LouisYOSHINAGA/rtsynth/kicad/pihat/rtsynth_pihat.kicad_sch

## KiCad design kicad/pihat/rtsynth_pihat.kicad_sch (2026-11-04)

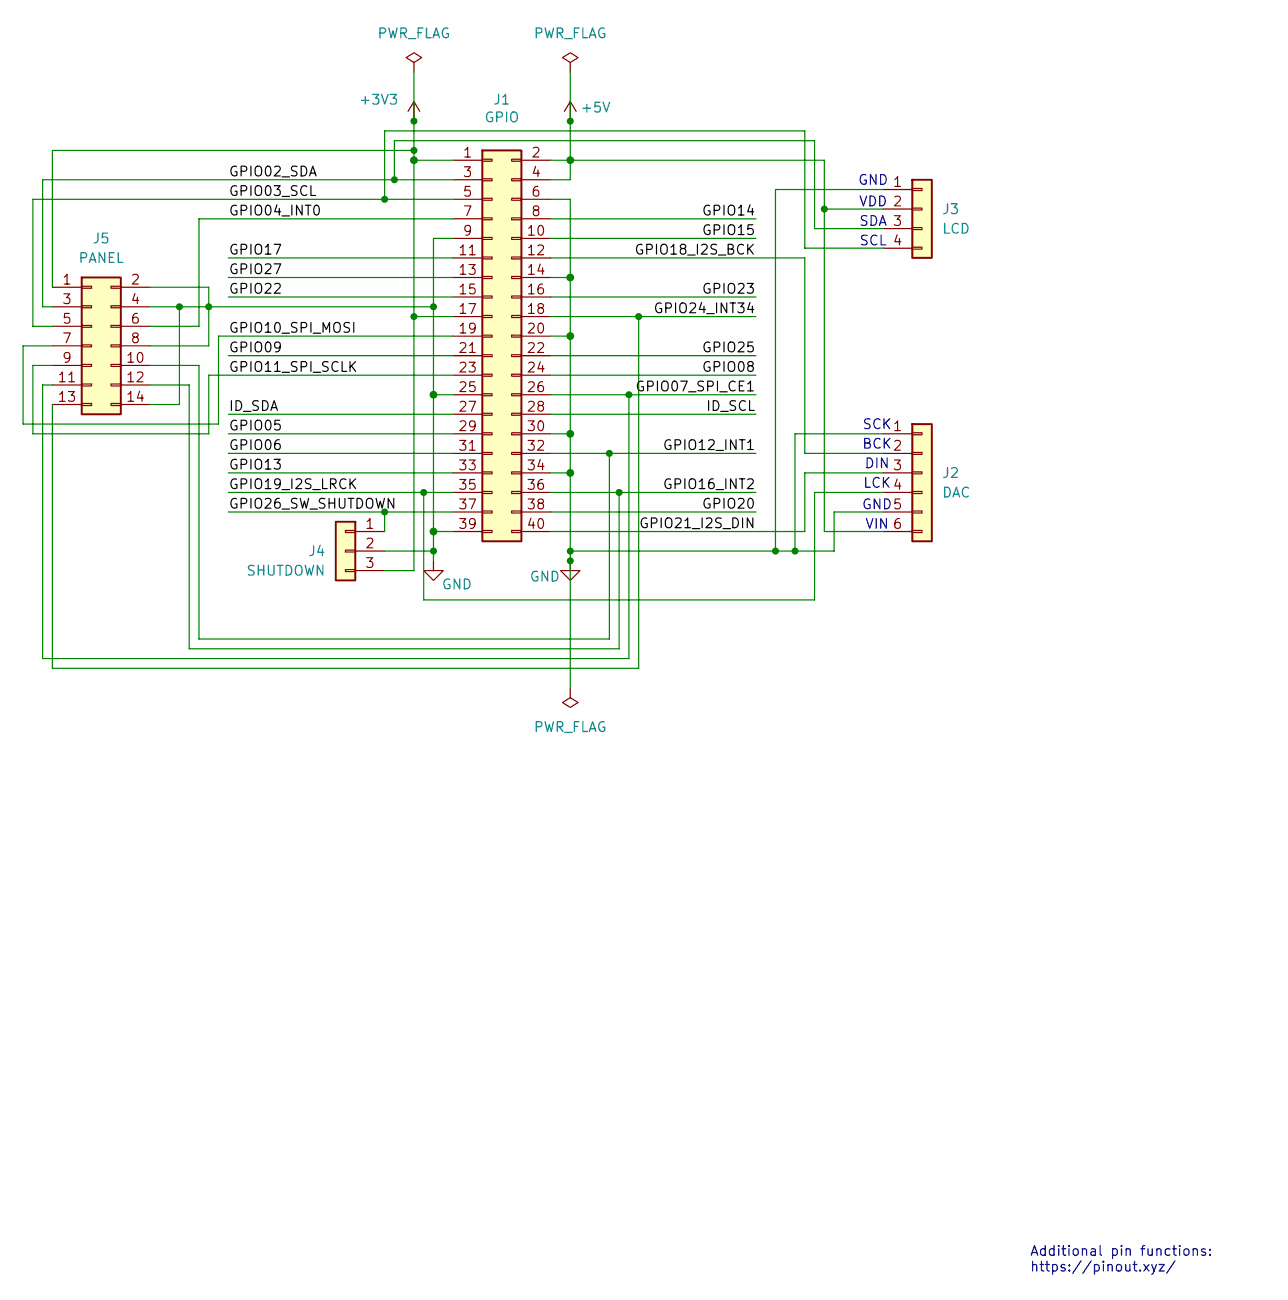
[picture p1: schematic rtsynth_pihat.kicad_sch]

Parts:
J1: GPIO; PinSocket_2x20_P2.54mm_Vertical
J2: DAC
J3: LCD
J4: SHUTDOWN
J5: PANEL

Connections:
+3V3: J1.1, J1.17, J4.3, J5.1
+5V: J1.2, J1.4, J2.6, J3.2
GND: J1.6, J1.9, J1.14, J1.20, J1.25, J1.30, J1.34, J1.39, J2.1, J2.5, J3.1, J4.2, J5.2, J5.4, J5.8, J5.14
GPIO02_SDA: J1.3, J3.3, J5.3
GPIO03_SCL: J1.5, J3.4, J5.5
GPIO04_INT0: J1.7, J5.6
GPIO05: J1.29
GPIO06: J1.31
GPIO07_SPI_CE1: J1.26, J5.11
GPIO08: J1.24
GPIO09: J1.21
GPIO10_SPI_MOSI: J1.19, J5.7
GPIO11_SPI_SCLK: J1.23, J5.9
GPIO12_INT1: J1.32, J5.10
GPIO13: J1.33
GPIO14: J1.8
GPIO15: J1.10
GPIO16_INT2: J1.36, J5.12
GPIO17: J1.11
GPIO18_I2S_BCK: J1.12, J2.2
GPIO19_I2S_LRCK: J1.35, J2.4
GPIO20: J1.38
GPIO21_I2S_DIN: J1.40, J2.3
GPIO22: J1.15
GPIO23: J1.16
GPIO24_INT34: J1.18, J5.13
GPIO25: J1.22
GPIO26_SW_SHUTDOWN: J1.37, J4.1
GPIO27: J1.13
ID_SCL: J1.28
ID_SDA: J1.27

Notes on the sheet:
SCL
VDD
VIN
GND
SDA
LCK
Additional pin functions: https://pinout.xyz/
BCK
DIN
SCK
