LouisYOSHINAGA/rtsynth/src/main.cpp

// Standalone entry point: parses CLI options, wires the chosen Processor
// into a StandaloneHost together with the optional hardware controls
// (MCP3008 pots, GPIO rotary encoders), then idles until SIGINT/SIGTERM.
// Designed to run headless (no interactive prompts) so it can be started
// from systemd on a hardware synth. This file is the only place that
// decides *which* Processor is built — swap the instrument here.

#include <algorithm>
#include <atomic>
#include <chrono>
#include <csignal>
#include <cstring>
#include <functional>
#include <iostream>
#include <memory>
#include <string>
#include <thread>
#include <utility>
#include <vector>

#include "host/ControlLoop.hpp"
#include "host/GpioButtonInput.hpp"
#include "host/GpioEncoderInput.hpp"
#include "host/I2cLcd1602.hpp"
#include "host/LcdParameterDisplay.hpp"
#include "host/Mcp23017Panel.hpp"
#include "host/Mcp3008Input.hpp"
#include "host/PanelConfig.hpp"
#include "host/PanelLogic.hpp"
#include "host/PdPanel.hpp"
#include "host/ParameterDisplay.hpp"
#include "host/ParameterMonitor.hpp"
#include "host/RawMidiInput.hpp"
#include "host/ShiftRegisterLeds.hpp"
#include "host/StandaloneHost.hpp"
#include "synth/SineSynthProcessor.hpp"
#ifdef RTSYNTH_HAVE_PD
#include "synth/PdSynthProcessor.hpp"
#endif

namespace {

std::atomic<bool> g_running{true};

void handleSignal(int){
    g_running.store(false);
}

void printUsage(const char* argv0){
    std::cout <<
        "Usage: " << argv0 << " [options]\n"
        "  -s, --synth <name>   instrument to run: sine, pd (default: sine)\n"
        "  -l, --list           list audio devices and MIDI ports, then exit\n"
        "  -a, --api <name>     audio API: alsa, pulse, jack, ...\n"
        "                       (default: direct ALSA when available — lowest latency)\n"
        "  -d, --device <id>    audio output device id (default: system default)\n"
        "  -m, --midi <index>   restrict MIDI input to one sequencer port index\n"
        "                       (default: connect to all ports, e.g. keyboard + CC box)\n"
        "                       devices may be plugged in at any time; they are picked\n"
        "                       up automatically, so none is needed at startup\n"
        "  --midi-raw <dev>     read MIDI straight from a kernel rawmidi device,\n"
        "                       bypassing the ALSA sequencer; repeatable, or 'all'\n"
        "                       for every device, including ones plugged in later\n"
        "                       (e.g. --midi-raw hw:1,0,0 — ids shown by --list)\n"
        "  -r, --rate <hz>      sample rate (default: 44100)\n"
        "  -b, --buffer <n>     buffer size in frames (default: 256)\n"
        "  -g, --gain <0..1>    master output volume, applied after the instrument\n"
        "                       and outside the presets (default: 1.0 = unchanged).\n"
        "                       The instrument's own gain/volume parameter is part\n"
        "                       of the preset: set that with --param instead\n"
        "  -p, --param <id=v>   set a synth parameter, repeatable\n"
        "                       (e.g. --param attack=0.001 --param release=0.1)\n"
        "  --preset <n>         start on preset n (= its Program Change number);\n"
        "                       switch at runtime by sending Program Change\n"
        "  --list-presets       list the instrument's presets, then exit\n"
        "  --adc <ch>=<id>      map an MCP3008 ADC channel to a parameter, repeatable\n"
        "                       (e.g. --adc 0=gain --adc 1=attack); needs SPI enabled\n"
        "  --adc-device <path>  SPI device of the ADC (default: /dev/spidev0.0)\n"
        "  --enc <A>,<B>=<id>   map a rotary encoder on GPIO pins A/B to a parameter,\n"
        "                       repeatable (e.g. --enc 17,27=line1_dcw_level1)\n"
        "  --enc-chip <path>    GPIO chip of the encoders (default: /dev/gpiochip0)\n"
        "  --enc-step <size>    normalized change per encoder detent (default: 0.01)\n"
        "  --button <pin>=<act> map a panel button on a GPIO pin to an action,\n"
        "                       repeatable. Actions: preset-next, preset-prev,\n"
        "                       revert (undo this preset's edits), panic\n"
        "                       (e.g. --button 5=preset-prev --button 6=preset-next)\n"
        "  --button-chip <path> GPIO chip of the buttons (default: /dev/gpiochip0)\n"
        "  --panel <file>       a control panel on MCP23017 I2C expanders: encoders,\n"
        "                       buttons and LEDs as described in <file>\n"
        "                       (see panels/pd_panel.conf)\n"
        "  --panel-led-test     with --panel: light every panel LED in turn at\n"
        "                       startup and print its role and pin (wiring check)\n"
        "  --lcd <addr>         show the last-changed parameter on a 16x2 I2C LCD\n"
        "                       at this address (e.g. --lcd 0x27; find with i2cdetect)\n"
        "  --lcd-bus <path>     I2C bus of the LCD (default: /dev/i2c-1)\n"
        "  --lcd-layout <file>  what the LCD rows say, as editable text templates\n"
        "                       (see lcd/pd_lcd.conf)\n"
        "  --voices <n>         cap polyphony (fewer voices = less CPU; the pd\n"
        "                       synth is expensive, try 8 or 6 if audio crackles)\n"
        "  -v, --verbose [what] trace what the synth is doing. With no argument\n"
        "                       everything is traced; otherwise a comma-separated\n"
        "                       list of:\n"
        "                         midi      received MIDI events\n"
        "                         param     parameter and preset changes, with the\n"
        "                                   CC that caused them\n"
        "                         load      DSP load meter, once a second\n"
        "                         voices    active voice count when it changes\n"
        "                         warnings  audio backend warnings\n"
        "                         panel     every --panel button and encoder event,\n"
        "                                   named by role and pin (wiring check)\n"
        "                         all       all of the above (the default)\n"
        "                       e.g. -v midi,param   or   --verbose=load\n"
        "  --midi-dump          also print the raw MIDI bytes as received, grouped\n"
        "                       per device read (--midi-raw) or per message;\n"
        "                       settles what the device really sent\n"
        "  -h, --help           show this help\n";
}

void listDevices(const std::string& apiName, bool verboseWarnings){
    rtsynth::RtAudioOutput audio;
    audio.setApi(apiName);
    // A device missing from this list failed to open when it was probed,
    // and the backend's warning is the only place that says why (busy,
    // no such card, ...) — which is the whole question when the list
    // comes back short or empty.
    audio.setVerboseWarnings(verboseWarnings);
    std::cout << "Audio API: " << audio.currentApiName() << std::endl;
    std::cout << "=== Audio Output Devices ===" << std::endl;
    for(const auto& device : audio.listOutputDevices()){
        std::cout << "  [" << device.id << "] " << device.name
                  << " (" << device.outputChannels << " ch)"
                  << (device.isDefault? " [default]" : "") << std::endl;
    }

    rtsynth::RtMidiInput midi;
    std::cout << "=== MIDI Input Ports (sequencer) ===" << std::endl;
    const auto ports = midi.listPorts();
    if(ports.empty()){
        std::cout << "  (none)" << std::endl;
    }
    for(size_t i = 0; i < ports.size(); i++){
        std::cout << "  [" << i << "] " << ports[i] << std::endl;
    }

    std::cout << "=== Raw MIDI Devices (--midi-raw) ===" << std::endl;
    const auto rawInputs = rtsynth::RawMidiInput::listInputs();
    if(rawInputs.empty()){
        std::cout << "  (none)" << std::endl;
    }
    for(const auto& [id, name] : rawInputs){
        std::cout << "  " << id << "  " << name << std::endl;
    }
}

// --- verbose (-v) console output ---------------------------------------------
//
// Parameter values are NOT printed here: that is ParameterMonitor's job,
// and it feeds the console backend and (later) an LCD from the same place.
// Only the raw MIDI trace lives in main.

void printMidiEvent(const std::string& portName, const rtsynth::MidiEvent& e){
    std::cout << "[midi] ";
    switch(e.type){
        case rtsynth::MidiEvent::Type::NoteOn:
            std::cout << "note on  ch " << +e.channel << "  note " << +e.data1
                      << "  vel " << +e.data2;
            break;
        case rtsynth::MidiEvent::Type::NoteOff:
            std::cout << "note off ch " << +e.channel << "  note " << +e.data1;
            break;
        case rtsynth::MidiEvent::Type::ControlChange:
            std::cout << "cc       ch " << +e.channel << "  cc " << +e.data1
                      << "  val " << +e.data2;
            break;
        case rtsynth::MidiEvent::Type::ProgramChange:
            std::cout << "program  ch " << +e.channel << "  number " << +e.data1;
            break;
        case rtsynth::MidiEvent::Type::PitchBend:
            std::cout << "bend     ch " << +e.channel << "  value " << e.pitchBend14;
            break;
    }
    std::cout << "  (" << portName << ")" << std::endl;
}

// --- option containers --------------------------------------------------------

// Which kinds of -v output are on. Each flag gates exactly one kind of
// console line, so a trace can be narrowed to what is being investigated
// instead of drowning it in the other three.
struct VerboseOptions {
    bool midi = false;      // [midi]    every received MIDI event
    bool param = false;     // [param] / [preset]  parameter and preset changes
    bool load = false;      // [load]    DSP load meter, once a second
    bool voices = false;    // [voices]  active voice count when it changes
    bool warnings = false;  // audio backend (ALSA/RtAudio) warnings
    bool panel = false;     // [panel]   --panel button / encoder events

    bool any() const { return midi || param || load || voices || warnings || panel; }
    void enableAll(){ midi = param = load = voices = warnings = panel = true; }
};

// Parses the comma-separated argument of -v. Returns false (after saying
// which name was wrong) so a typo is a startup error rather than silently
// missing output.
bool parseVerboseCategories(const std::string& text, VerboseOptions& out){
    for(size_t begin = 0; ; ){
        const size_t comma = text.find(',', begin);
        const std::string name = text.substr(begin, comma - begin);
        if(name == "all"){
            out.enableAll();
        }else if(name == "midi"){
            out.midi = true;
        }else if(name == "param"){
            out.param = true;
        }else if(name == "load"){
            out.load = true;
        }else if(name == "voices"){
            out.voices = true;
        }else if(name == "panel"){
            out.panel = true;
        }else if(name == "warnings"){
            out.warnings = true;
        }else{
            std::cerr << "Unknown -v category '" << name << "'. Available: "
                         "midi, param, load, voices, warnings, panel, all" << std::endl;
            return false;
        }
        if(comma == std::string::npos){
            return true;
        }
        begin = comma + 1;
    }
}

struct EncoderMapping {
    unsigned int pinA;
    unsigned int pinB;
    std::string paramId;
};

// A panel button and what pressing it does. Kept as a string until the
// instrument is built, so an action that needs presets can say so with a
// real message instead of silently doing nothing.
struct ButtonMapping {
    unsigned int pin;
    std::string action;
};

constexpr const char* kButtonActions =
    "preset-next, preset-prev, revert, panic";

bool isButtonAction(const std::string& action){
    return action == "preset-next" || action == "preset-prev"
        || action == "revert" || action == "panic";
}

struct CliOptions {
    rtsynth::StandaloneHost::Options host;
    std::string synthName = "sine";
    float gain = -1.0f;
    bool listRequested = false;
    std::vector<std::pair<std::string, float>> paramOverrides;
    std::vector<std::pair<int, std::string>> adcMappings;
    std::string adcDevice = "/dev/spidev0.0";
    std::vector<EncoderMapping> encoderMappings;
    std::string encoderChip = "/dev/gpiochip0";
    float encoderStep = 0.01f;
    std::vector<ButtonMapping> buttonMappings;
    std::string buttonChip = "/dev/gpiochip0";
    std::string panelConfig;           // --panel file, "" = no expander panel
    bool panelLedTest = false;
    int lcdAddress = -1;               // -1 = no LCD
    std::string lcdBus = "/dev/i2c-1";
    std::string lcdLayout;             // --lcd-layout file, "" = built-in text
    int maxVoices = 0;                 // 0 = instrument default
    int preset = -1;                   // -1 = the instrument's default slot
    bool listPresets = false;
    bool midiDump = false;
    VerboseOptions verbose;
};

// Returns false (after printing a message) when the arguments are invalid;
// exitRequested is set when a flag like --help fully handles the run.
bool parseArguments(int argc, char* argv[], CliOptions& cli, bool& exitRequested){
    exitRequested = false;
    try{
        for(int i = 1; i < argc; i++){
            const std::string arg = argv[i];
            auto nextArg = [&]() -> const char* {
                return (i + 1 < argc)? argv[++i] : nullptr;
            };
            auto splitAssignment = [](const std::string& text, const char* flag,
                                      std::string& left, std::string& right){
                const size_t eq = text.find('=');
                if(eq == std::string::npos){
                    std::cerr << flag << " expects <...>=<...>, got: " << text << std::endl;
                    return false;
                }
                left = text.substr(0, eq);
                right = text.substr(eq + 1);
                return true;
            };

            if(arg == "-h" || arg == "--help"){
                printUsage(argv[0]);
                exitRequested = true;
                return true;
            }else if(arg == "-l" || arg == "--list"){
                cli.listRequested = true;  // handled after parsing so --api applies
            }else if(arg == "-s" || arg == "--synth"){
                if(const char* v = nextArg()) cli.synthName = v;
            }else if(arg == "-a" || arg == "--api"){
                if(const char* v = nextArg()) cli.host.audioApiName = v;
            }else if(arg == "-d" || arg == "--device"){
                if(const char* v = nextArg()) cli.host.audioDeviceId = std::stoul(v);
            }else if(arg == "-m" || arg == "--midi"){
                if(const char* v = nextArg()) cli.host.midiPortIndex = std::stoi(v);
            }else if(arg == "--midi-raw"){
                if(const char* v = nextArg()) cli.host.rawMidiDevices.push_back(v);
            }else if(arg == "-r" || arg == "--rate"){
                if(const char* v = nextArg()) cli.host.sampleRate = std::stoul(v);
            }else if(arg == "-b" || arg == "--buffer"){
                if(const char* v = nextArg()) cli.host.bufferFrames = std::stoul(v);
            }else if(arg == "-g" || arg == "--gain"){
                if(const char* v = nextArg()) cli.gain = std::stof(v);
            }else if(arg == "-p" || arg == "--param"){
                if(const char* v = nextArg()){
                    std::string id, value;
                    if(!splitAssignment(v, "--param", id, value)) return false;
                    cli.paramOverrides.emplace_back(id, std::stof(value));
                }
            }else if(arg == "--adc"){
                if(const char* v = nextArg()){
                    std::string channel, id;
                    if(!splitAssignment(v, "--adc", channel, id)) return false;
                    cli.adcMappings.emplace_back(std::stoi(channel), id);
                }
            }else if(arg == "--adc-device"){
                if(const char* v = nextArg()) cli.adcDevice = v;
            }else if(arg == "--enc"){
                if(const char* v = nextArg()){
                    std::string pins, id;
                    if(!splitAssignment(v, "--enc", pins, id)) return false;
                    const size_t comma = pins.find(',');
                    if(comma == std::string::npos){
                        std::cerr << "--enc expects <pinA>,<pinB>=<param id>, got: "
                                  << v << std::endl;
                        return false;
                    }
                    cli.encoderMappings.push_back({
                        static_cast<unsigned int>(std::stoul(pins.substr(0, comma))),
                        static_cast<unsigned int>(std::stoul(pins.substr(comma + 1))),
                        id});
                }
            }else if(arg == "--button"){
                if(const char* v = nextArg()){
                    std::string pin, action;
                    if(!splitAssignment(v, "--button", pin, action)) return false;
                    if(!isButtonAction(action)){
                        std::cerr << "--button action '" << action
                                  << "' is unknown. Available: " << kButtonActions
                                  << std::endl;
                        return false;
                    }
                    cli.buttonMappings.push_back(
                        {static_cast<unsigned int>(std::stoul(pin)), action});
                }
            }else if(arg == "--panel"){
                if(const char* v = nextArg()) cli.panelConfig = v;
            }else if(arg == "--panel-led-test"){
                cli.panelLedTest = true;
            }else if(arg == "--button-chip"){
                if(const char* v = nextArg()) cli.buttonChip = v;
            }else if(arg == "--enc-chip"){
                if(const char* v = nextArg()) cli.encoderChip = v;
            }else if(arg == "--enc-step"){
                if(const char* v = nextArg()) cli.encoderStep = std::stof(v);
            }else if(arg == "--lcd"){
                if(const char* v = nextArg()){
                    cli.lcdAddress = static_cast<int>(std::stoul(v, nullptr, 0));  // "0x27" ok
                }
            }else if(arg == "--lcd-bus"){
                if(const char* v = nextArg()) cli.lcdBus = v;
            }else if(arg == "--lcd-layout"){
                if(const char* v = nextArg()) cli.lcdLayout = v;
            }else if(arg == "--voices"){
                if(const char* v = nextArg()) cli.maxVoices = std::stoi(v);
            }else if(arg == "--preset"){
                if(const char* v = nextArg()) cli.preset = std::stoi(v);
            }else if(arg == "--list-presets"){
                cli.listPresets = true;
            }else if(arg == "--midi-dump"){
                cli.midiDump = true;
            }else if(arg == "-v" || arg == "--verbose"){
                // The category list is optional. Only take the next token
                // when it cannot be another option, so "-v --synth pd"
                // still means "-v" plus "--synth pd".
                if(i + 1 < argc && argv[i + 1][0] != '-'){
                    if(!parseVerboseCategories(argv[++i], cli.verbose)) return false;
                }else{
                    cli.verbose.enableAll();
                }
            }else if(arg.rfind("--verbose=", 0) == 0){
                if(!parseVerboseCategories(arg.substr(10), cli.verbose)) return false;
            }else{
                std::cerr << "Unknown option: " << arg << std::endl;
                printUsage(argv[0]);
                return false;
            }
        }
    }catch(const std::exception&){
        std::cerr << "Invalid option value." << std::endl;
        printUsage(argv[0]);
        return false;
    }
    return true;
}

// Builds the --panel hardware from its config file and gives every
// control its job. The roles are resolved by PanelLogic and the pd panel
// modules (PdPanel.hpp: rowR.*, line, tone*, compare, dv.*, ..., plus the
// generic abs.* and param:<id>); a button role none of them knows may be
// a host action (preset-next, preset-prev, revert, panic).
//
// What setUpPanel hands back: per expander button its handler and a
// label for traces, and every LED for the LED test.
struct PanelWiring {
    std::vector<rtsynth::PanelLogic::ButtonFn> buttonHandlers;
    std::vector<std::string> buttonLabels;   // "row1.eg (3.A0)"
    struct Led {
        std::string label;                   // "row1.dco (sr2.0)"
        rtsynth::LedOutput* output;
        int channel;
    };
    std::vector<Led> leds;
};

bool setUpPanel(const std::string& path, rtsynth::Mcp23017Panel& panel,
                rtsynth::ShiftRegisterLeds& shiftLeds, rtsynth::PanelLogic& logic,
                rtsynth::ControlLoop& controlLoop, rtsynth::Processor& synth,
                const rtsynth::PdToneSelect::Host& toneHost,
                const std::function<bool(const std::string&, const std::string&)>& checkAction,
                const std::function<void(const std::string&)>& performAction,
                PanelWiring& wiring){
    rtsynth::PanelConfig config;
    std::string error;
    if(!rtsynth::loadPanelConfig(path, config, error)){
        std::cerr << "--panel: " << error << std::endl;
        return false;
    }
    auto fail = [&path](int line, const std::string& message){
        std::cerr << "--panel: " << path << ", line " << line << ": " << message << std::endl;
        return false;
    };

    for(const auto& expander : config.expanders){
        if(panel.addExpander(expander.address, expander.interruptLine) < 0){
            std::cerr << "--panel: " << path << ": " << panel.lastError() << std::endl;
            return false;
        }
    }

    rtsynth::ParameterSet& parameters = synth.parameters();
    logic.setStepSize(config.encoderStep);
    logic.addModule(std::make_unique<rtsynth::PdLineEditor>(logic, parameters));
    logic.addModule(std::make_unique<rtsynth::PdLineSelect>(logic, parameters));
    logic.addModule(std::make_unique<rtsynth::PdToneSelect>(synth.presets(), toneHost));
    logic.addModule(std::make_unique<rtsynth::PdDetuneVibrato>(logic, parameters));

    for(const auto& e : config.encoders){
        const int channel = panel.addEncoder(e.a, e.b);
        if(channel < 0){
            return fail(e.line, panel.lastError());
        }
        const std::string label = e.role + " (" + rtsynth::Mcp23017Panel::pinName(e.a) + "/"
                                + rtsynth::Mcp23017Panel::pinName(e.b) + ")";
        if(!logic.attachEncoder(e.role, &panel.encoders(), channel, label)){
            return fail(e.line, "unknown encoder role '" + e.role + "'");
        }
    }

    for(const auto& b : config.buttons){
        if(panel.addButton(b.pin) < 0){
            return fail(b.line, panel.lastError());
        }
        rtsynth::PanelLogic::ButtonFn fn = logic.button(b.role);
        if(!fn){
            if(!checkAction("--panel line " + std::to_string(b.line), b.role)){
                return false;
            }
            fn = [performAction, action = b.role](bool pressed){
                if(pressed){
                    performAction(action);
                }
            };
        }
        wiring.buttonHandlers.push_back(std::move(fn));
        wiring.buttonLabels.push_back(b.role + " (" + rtsynth::Mcp23017Panel::pinName(b.pin) + ")");
    }

    shiftLeds.setChainLength(config.shiftChips);
    for(const auto& l : config.leds){
        rtsynth::LedOutput* output = &shiftLeds;
        int channel = l.shiftChannel;
        if(l.onShiftRegister){
            shiftLeds.setActiveLow(channel, l.activeLow);
        }else{
            output = &panel.leds();
            channel = panel.addLed(l.pin, l.activeLow);
            if(channel < 0){
                return fail(l.line, panel.lastError());
            }
        }
        if(!logic.attachLed(l.role, output, channel)){
            return fail(l.line, "unknown LED role '" + l.role + "'");
        }
        wiring.leds.push_back({l.role + " (" + (l.onShiftRegister
                                   ? rtsynth::ShiftRegisterLeds::pinName(channel)
                                   : rtsynth::Mcp23017Panel::pinName(l.pin)) + ")",
                               output, channel});
    }

    for(const std::string& warning : logic.warnings()){
        std::cerr << "[panel] " << warning << std::endl;
    }

    if(!panel.open(config.options)){
        return false;
    }
    if(config.shiftChips > 0 && !shiftLeds.open(config.shiftDevice)){
        return false;
    }
    controlLoop.addSurface(&logic);

    int interruptLines = 0;
    for(const auto& expander : config.expanders){
        interruptLines += (expander.interruptLine >= 0)? 1 : 0;
    }
    std::cout << "Panel: " << panel.presentExpanders() << " of " << panel.numExpanders()
              << " MCP23017 on "
              << config.options.busPath << ", " << config.encoders.size() << " encoders, "
              << config.buttons.size() << " buttons, " << config.leds.size() << " LEDs"
              << (config.shiftChips > 0
                      ? " (" + std::to_string(config.shiftChips) + " x 74HC595 on "
                        + config.shiftDevice + ")"
                      : std::string())
              << (interruptLines > 0
                      ? ", per-chip interrupts"
                  : config.options.interruptLine >= 0
                      ? ", interrupt on GPIO" + std::to_string(config.options.interruptLine)
                      : ", polled at " + std::to_string(config.options.scanRateHz) + " Hz")
              << std::endl;
    return true;
}

std::unique_ptr<rtsynth::Processor> createSynth(const std::string& name){
    if(name == "sine"){
        return std::make_unique<rtsynth::SineSynthProcessor>();
    }
    if(name == "pd"){
#ifdef RTSYNTH_HAVE_PD
        return std::make_unique<rtsynth::PdSynthProcessor>();
#else
        std::cerr << "This build has no PD synth (external/pd submodule was missing).\n"
                     "Run: git submodule update --init && rebuild." << std::endl;
        return nullptr;
#endif
    }
    std::cerr << "Unknown synth: " << name << " (available: sine, pd)" << std::endl;
    return nullptr;
}

}  // namespace

int main(int argc, char* argv[]){
    CliOptions cli;
    bool exitRequested = false;
    if(!parseArguments(argc, argv, cli, exitRequested)){
        return 1;
    }
    if(exitRequested){
        return 0;
    }
    // the backend flags the host needs are derived from what is traced:
    // the MIDI monitor queues feed both the [midi] lines and the CC that
    // each [param] line is attributed to
    cli.host.verboseWarnings = cli.verbose.warnings;
    cli.host.monitorMidi = cli.verbose.midi || cli.verbose.param
                           || cli.lcdAddress >= 0;
    if(cli.listRequested){
        listDevices(cli.host.audioApiName, cli.verbose.warnings);
        return 0;
    }

    std::unique_ptr<rtsynth::Processor> synth = createSynth(cli.synthName);
    if(synth == nullptr){
        return 1;
    }
    std::cout << "Instrument: " << synth->name() << std::endl;

    rtsynth::PresetBank* presets = synth->presets();
    if(cli.listPresets){
        if(presets == nullptr || presets->empty()){
            std::cout << "This instrument has no presets." << std::endl;
            return 0;
        }
        std::cout << "Presets (the number is the Program Change value):" << std::endl;
        for(int i = 0; i < presets->count(); i++){
            std::cout << "  " << i << "  " << presets->name(i) << std::endl;
        }
        return 0;
    }
    if(presets != nullptr && !presets->empty()){
        if(cli.preset >= 0){
            if(cli.preset >= presets->count()){
                std::cerr << "No preset " << cli.preset << " (have 0.."
                          << presets->count() - 1 << ")." << std::endl;
                return 1;
            }
            presets->select(cli.preset);
        }
        std::cout << "Preset " << presets->current() << ": " << presets->currentName()
                  << " (" << presets->count()
                  << " slots, switch with Program Change)" << std::endl;
    }

    if(cli.maxVoices > 0){
        synth->setMaxVoices(cli.maxVoices);
        std::cout << "Polyphony capped at " << cli.maxVoices << " voices" << std::endl;
    }

    // -g is the box's volume knob, not the patch's: it scales the finished
    // output in the host, so switching preset (or reverting one) cannot
    // undo it the way writing the instrument's own gain parameter would.
    if(cli.gain >= 0.0f){
        // clamped because this now multiplies the finished output: above
        // unity it would clip the DAC rather than the instrument's own
        // limiter, which is not a useful thing to allow by typo
        cli.host.masterGain = std::min(cli.gain, 1.0f);
    }

    auto findParameter = [&synth](const std::string& id) -> rtsynth::Parameter* {
        rtsynth::Parameter* parameter = synth->parameters().byId(id);
        if(parameter == nullptr){
            std::cerr << "Unknown parameter '" << id << "'. Available:" << std::endl;
            for(auto& p : synth->parameters()){
                std::cerr << "  " << p->id() << " [" << p->min() << ".." << p->max()
                          << "] (default " << p->defaultValue() << ")"
                          << (p->unit().empty()? "" : " ") << p->unit() << std::endl;
            }
        }
        return parameter;
    };

    for(const auto& [id, value] : cli.paramOverrides){
        rtsynth::Parameter* parameter = findParameter(id);
        if(parameter == nullptr){
            return 1;
        }
        parameter->set(value);
    }

    rtsynth::StandaloneHost host(*synth);
    if(!host.start(cli.host)){
        return 1;
    }
    if(cli.midiDump){
        host.midi().setRawDumpEnabled(true);
    }

    // --- optional hardware controls ------------------------------------------
    //
    // Every input is declared before the ControlLoop: the loop's thread
    // reads them (and the strings and panel logic its handlers use), so
    // they must be destroyed after it — and destruction runs in reverse.
    rtsynth::Mcp3008Input adc;                 // pots (absolute)
    rtsynth::GpioEncoderInput encoders;        // encoders on Pi GPIO (relative)
    rtsynth::GpioButtonInput buttons;          // buttons on Pi GPIO
    rtsynth::Mcp23017Panel panel;              // encoders/buttons/LEDs on expanders
    rtsynth::ShiftRegisterLeds shiftLeds;      // LEDs on a 74HC595 chain
    rtsynth::PanelLogic panelLogic(synth->parameters());  // what the panel controls do
    std::vector<std::string> gpioButtonActions;
    PanelWiring panelWiring;
    rtsynth::ControlLoop controlLoop(&adc, &encoders);

    const bool havePresets = (presets != nullptr && !presets->empty());

    // Runs on the ControlLoop thread — the one thread allowed to feed the
    // host's control queues — so every action becomes an event for the
    // audio thread to apply.
    // (Handlers take it by value: it is declared after the loop, so a
    // reference would dangle while an early return tears things down.)
    auto performAction = [&host, presets](const std::string& action){
        if(action == "panic"){
            // CC120 All Sound Off, the same message a panic button on a
            // MIDI controller sends
            host.sendControlEvent(rtsynth::MidiEvent::controlChange(0, 120, 0));
        }else if(action == "revert"){
            host.sendCommand(rtsynth::HostCommand::RevertPreset);
        }else{
            const int delta = (action == "preset-next")? +1 : -1;
            host.sendControlEvent(rtsynth::MidiEvent::programChange(
                0, static_cast<uint8_t>(presets->neighbour(delta))));
        }
    };
    auto checkAction = [&](const std::string& where, const std::string& action){
        if(!isButtonAction(action)){
            std::cerr << where << ": unknown button action '" << action
                      << "'. Available: " << kButtonActions << std::endl;
            return false;
        }
        if(!havePresets && action != "panic"){
            std::cerr << where << ": '" << action << "' needs an instrument with presets; "
                      << synth->name() << " has none." << std::endl;
            return false;
        }
        return true;
    };

    if(!cli.adcMappings.empty()){
        if(!adc.open(cli.adcDevice)){
            return 1;
        }
        for(const auto& [channel, id] : cli.adcMappings){
            rtsynth::Parameter* parameter = findParameter(id);
            if(parameter == nullptr){
                return 1;
            }
            controlLoop.addMapping(channel, parameter);
        }
        std::cout << "ADC control: " << adc.name() << " on " << cli.adcDevice
                  << ", " << cli.adcMappings.size() << " mapping(s)" << std::endl;
    }

    if(!cli.encoderMappings.empty()){
        for(const EncoderMapping& mapping : cli.encoderMappings){
            rtsynth::Parameter* parameter = findParameter(mapping.paramId);
            if(parameter == nullptr){
                return 1;
            }
            const int channel = encoders.addEncoder(mapping.pinA, mapping.pinB);
            controlLoop.addRelativeMapping(channel, parameter, cli.encoderStep);
        }
        if(!encoders.open(cli.encoderChip)){
            return 1;
        }
        std::cout << "Encoder control: " << encoders.name() << " on " << cli.encoderChip
                  << ", " << cli.encoderMappings.size() << " mapping(s)" << std::endl;
    }

    if(!cli.buttonMappings.empty()){
        for(const ButtonMapping& mapping : cli.buttonMappings){
            if(!checkAction("--button " + std::to_string(mapping.pin), mapping.action)){
                return 1;
            }
            buttons.addButton(mapping.pin);
            gpioButtonActions.push_back(mapping.action);
        }
        controlLoop.addButtons(&buttons,
            [&gpioButtonActions, performAction](int channel, bool pressed){
                if(pressed){  // act on the press; the release edge is spare
                    performAction(gpioButtonActions[static_cast<size_t>(channel)]);
                }
            });
        if(!buttons.open(cli.buttonChip)){
            return 1;
        }
        std::cout << "Buttons: " << cli.buttonMappings.size() << " on "
                  << cli.buttonChip
                  << (buttons.debounceActive()? "" : " (no kernel debounce)")
                  << std::endl;
    }

    if(!cli.panelConfig.empty()){
        // Tone selection talks to the audio thread the same way the
        // preset buttons do: from the ControlLoop thread, through the
        // host's control queues.
        rtsynth::PdToneSelect::Host toneHost;
        toneHost.programChange = [&host](int program){
            host.sendControlEvent(rtsynth::MidiEvent::programChange(
                0, static_cast<uint8_t>(program)));
        };
        toneHost.toggleCompare = [&host]{ host.sendCommand(rtsynth::HostCommand::ToggleCompare); };
        toneHost.initialize = [&host]{ host.sendCommand(rtsynth::HostCommand::RevertPreset); };
        if(!setUpPanel(cli.panelConfig, panel, shiftLeds, panelLogic, controlLoop, *synth,
                       toneHost, checkAction, performAction, panelWiring)){
            return 1;
        }
        const bool trace = cli.verbose.panel;
        if(trace){
            panelLogic.setTrace([](const std::string& line){
                std::cout << "[panel] " << line << std::endl;
            });
        }
        controlLoop.addButtons(&panel.buttons(),
            [&panelWiring, trace](int channel, bool pressed){
                const size_t i = static_cast<size_t>(channel);
                if(trace){
                    std::cout << "[panel] button " << panelWiring.buttonLabels[i]
                              << (pressed? " down" : " up") << std::endl;
                }
                panelWiring.buttonHandlers[i](pressed);
            });
        if(cli.panelLedTest){
            // one LED at a time, named, before the panel logic takes over
            std::cout << "[panel] LED test: " << panelWiring.leds.size() << " LEDs" << std::endl;
            for(const auto& led : panelWiring.leds){
                std::cout << "[panel] LED " << led.label << std::endl;
                led.output->setLed(led.channel, true);
                led.output->flush();
                std::this_thread::sleep_for(std::chrono::milliseconds(400));
                led.output->setLed(led.channel, false);
                led.output->flush();
            }
        }
    }

    if(controlLoop.hasWork()){
        controlLoop.start();
    }

    // optional 16x2 I2C LCD. It is a ParameterDisplay like the console
    // one, so it is fed by the same ParameterMonitor below and shows the
    // same lines --verbose prints; only the drawing differs.
    rtsynth::I2cLcd1602 lcd;
    rtsynth::LcdParameterDisplay lcdDisplay(lcd);
    if(cli.lcdAddress >= 0){
        if(!lcd.open(cli.lcdBus, static_cast<uint8_t>(cli.lcdAddress))){
            return 1;
        }
        if(!cli.lcdLayout.empty()){
            rtsynth::LcdLayout layout;
            std::string error;
            if(!rtsynth::loadLcdLayout(cli.lcdLayout, layout, error)){
                std::cerr << "--lcd-layout: " << error << std::endl;
                return 1;
            }
            lcdDisplay.setLayout(std::move(layout));
            std::cout << "LCD layout: " << cli.lcdLayout << std::endl;
        }
        lcdDisplay.showStartup(synth->name(), presets != nullptr && !presets->empty()?
                                              presets->currentName() : "ready");
        std::cout << "LCD: 16x2 on " << cli.lcdBus << " addr 0x"
                  << std::hex << cli.lcdAddress << std::dec << std::endl;
    }

    std::signal(SIGINT, handleSignal);
    std::signal(SIGTERM, handleSignal);
    std::cout << "Running. Press Ctrl+C to quit." << std::endl;

    // Reports what changed — from MIDI CC, pots, encoders or a preset
    // switch — to every attached display: the -v console trace, the LCD,
    // or both at once.
    rtsynth::ParameterMonitor monitor(*synth);
    rtsynth::ConsoleParameterDisplay console;
    if(cli.verbose.param){
        monitor.addDisplay(&console);
    }
    if(cli.lcdAddress >= 0){
        monitor.addDisplay(&lcdDisplay);
    }

    uint64_t lastXruns = 0;
    uint64_t lastDrops = 0;
    uint64_t lastDeferrals = 0;
    uint64_t lastUndecoded = 0;
    int lastVoices = -1;
    int loadTicks = 0;
    uint64_t lastReadErrors = 0;
    uint64_t lastPanelErrors = 0;
    bool schedulingReported = false;
    // poll faster when something is being traced so the prints feel
    // immediate; otherwise this loop only watches the error counters
    const bool watching = cli.verbose.any() || monitor.hasDisplays();
    const auto pollPeriod = std::chrono::milliseconds(watching? 50 : 500);
    // Hot-plug poll: the synth may have been powered on with no keyboard
    // attached, and a USB cable can be pulled at any point. Once a second
    // is responsive enough to feel immediate and costs nothing measurable.
    const int midiRescanEvery = std::max<int>(1, 1000 / static_cast<int>(pollPeriod.count()));
    int midiRescanTicks = 0;
    while(g_running.load()){
        std::this_thread::sleep_for(pollPeriod);

        // connect devices that appeared, release ones that went away
        // (which also releases the notes they were holding)
        if(++midiRescanTicks >= midiRescanEvery){
            midiRescanTicks = 0;
            if(host.rescanMidi()){
                std::cout << "MIDI input: " << host.midi().description() << std::endl;
            }
        }

        // report once whether the audio thread really got realtime
        // scheduling — silently missing rtprio permission is the most
        // common cause of crackling on a Raspberry Pi
        if(!schedulingReported && host.audio().audioThreadPolicy() >= 0){
            schedulingReported = true;
            if(host.audio().audioThreadIsRealtime()){
                std::cout << "Audio thread: realtime scheduling active" << std::endl;
            }else{
                std::cerr <<
                    "[warning] audio thread did NOT get realtime priority — crackling\n"
                    "          under load is expected. Fix: add your user to the 'audio'\n"
                    "          group and create /etc/security/limits.d/audio.conf with:\n"
                    "            @audio - rtprio 95\n"
                    "            @audio - memlock unlimited\n"
                    "          then log out and back in." << std::endl;
            }
        }

        if(cli.midiDump){
            // One line per read() from the device, so a burst that is
            // missing a message is visibly different from a burst that
            // never arrived at all.
            bool open = false;
            host.midi().drainRawDump([&open](uint8_t byte, bool startsGroup){
                if(startsGroup){
                    if(open){
                        std::cout << std::endl;
                    }
                    std::cout << "[read]";
                    open = true;
                }
                std::printf(" %02X", byte);
            });
            if(open){
                std::cout << std::endl;
            }
        }

        // the CC and the parameter it moved are reported together, so the
        // monitor needs to see the events before it polls the parameters
        host.midi().drainMonitor(
            [&cli, &monitor](const std::string& portName, const rtsynth::MidiEvent& event){
                if(cli.verbose.midi){
                    printMidiEvent(portName, event);
                }
                monitor.noteMidiEvent(event);
            });
        monitor.poll();

        // DSP load: > ~0.8 means the render barely fits the deadline and
        // crackling is a CPU problem (lower --voices / raise --buffer).
        // Summarized once a second so it doesn't drown the MIDI trace.
        if(cli.verbose.load && ++loadTicks >= 20){
            loadTicks = 0;
            const float peak = host.audio().peakLoad();
            std::printf("[load] %.0f%% peak / %.0f%% now, %d voices%s\n",
                        peak * 100.0f, host.audio().currentLoad() * 100.0f,
                        synth->activeVoiceCount(),
                        (peak > 0.8f)? "  <-- too high, lower --voices" : "");
            host.audio().resetPeakLoad();
        }

        // stuck-voice gauge: a count pinned at the maximum while no key
        // is held means voices never end (lost note-offs / stalled EGs)
        if(cli.verbose.voices){
            const int voices = synth->activeVoiceCount();
            if(voices != lastVoices){
                std::cout << "[voices] " << voices << " active" << std::endl;
                lastVoices = voices;
            }
        }

        // report problems from the main thread, never from RT threads
        const uint64_t xruns = host.audio().xrunCount();
        if(xruns != lastXruns){
            std::cerr << "[warning] audio under/overflow (total: " << xruns << ")" << std::endl;
            lastXruns = xruns;
        }
        const uint64_t drops = host.midi().droppedCount();
        if(drops != lastDrops){
            std::cerr << "[warning] MIDI events dropped (total: " << drops << ")" << std::endl;
            lastDrops = drops;
        }
        const uint64_t deferrals = host.midiDeferralCount();
        if(deferrals != lastDeferrals){
            std::cerr << "[warning] MIDI backlog deferred to next block (total: "
                      << deferrals << ")" << std::endl;
            lastDeferrals = deferrals;
        }
        const uint64_t undecoded = host.midi().undecodedCount();
        if(undecoded != lastUndecoded){
            std::cerr << "[warning] undecodable MIDI messages (total: " << undecoded
                      << ")" << std::endl;
            lastUndecoded = undecoded;
        }
        const uint64_t panelErrors = panel.readErrorCount();
        if(panelErrors != lastPanelErrors){
            std::cerr << "[warning] I2C errors on the expander panel — check its wiring"
                         " (total: " << panelErrors << ")" << std::endl;
            lastPanelErrors = panelErrors;
        }
        const uint64_t readErrors = host.midi().readErrorCount();
        if(readErrors != lastReadErrors){
            std::cerr << "[warning] MIDI device read errors — the kernel buffer"
                         " overran and bytes were lost (total: " << readErrors << ")"
                      << std::endl;
            lastReadErrors = readErrors;
        }
    }

    std::cout << "\nShutting down." << std::endl;
    if(cli.lcdAddress >= 0){
        lcdDisplay.showStop();
    }
    controlLoop.stop();
    shiftLeds.close();
    panel.close();
    encoders.close();
    host.stop();
    return 0;
}
