LouisYOSHINAGA/rtsynth/src/synth/PdSynthProcessor.hpp

#pragma once

#include <algorithm>
#include <array>
#include <string>
#include <vector>

#include "../core/Processor.hpp"
#include "../dsp/SmoothedValue.hpp"

// DSP core of the LouisYOSHINAGA/pd VST3 plugin (git submodule external/pd).
// These headers depend on the VST3 SDK only through the type aliases in
// pluginterfaces/vst/vsttypes.h, which src/vst3shim/ provides here.
#include "const.h"
#include "voice.h"

namespace rtsynth {

// Hosts the CZ-style phase distortion synth from the pd repository as an
// rtsynth Processor — the standalone counterpart of pd's PDProcessor
// (processor.cpp), minus the VST3 plumbing (state streams, oscilloscope
// messages, host parameter queues).
//
// The pd DSP core (PD lines, 8-step EGs, Voice) is used completely
// unmodified via the external/pd submodule; what this class reimplements
// is only the hosting logic: parameter dispatch, the voice pool with
// oldest-voice stealing, mono (SOLO) last-note priority, detune, pitch
// bend and the output mix. All of pd's parameters are registered in the
// ParameterSet as normalized [0,1] values (same encoding as the plugin),
// so MIDI CC, --param and --adc can address every one of them, e.g.
// "line1_dcw_rate1" or "detune_fine".
//
// Unlike the plugin (whose fresh state is silent until the editor pushes
// values), the parameter defaults here form a small init patch — sawtooth
// on line 1 with a fast-attack DCA and a DCW sweep — so the synth makes a
// sound out of the box. That patch is also the first slot of a factory
// preset bank; MIDI Program Change switches slots, and CC keeps editing
// whichever one is live (see PresetBank).
//
// Known caveat inherited from pd: switching a waveform parameter allocates
// the new generator object on the audio thread (PD::setWaveformFirst uses
// make_unique). Fine for patch editing; avoid automating waveform switches
// per-block on a real-time box.
class PdSynthProcessor : public Processor {
public:
    PdSynthProcessor();

    const char* name() const override { return "rtsynth.pd"; }

    void prepare(double sampleRate, int maxBlockSize) override;
    void reset() override;
    void process(AudioBufferView& output, const MidiBuffer& midi) override;

    PresetBank* presets() override { return &presets_; }
    Parameter* parameterForCc(uint8_t cc) override;
    std::string describeValue(const Parameter& parameter) const override;

    // counts only the voices the render loop actually visits, so the gauge
    // matches what is really sounding under a --voices cap
    int activeVoiceCount() const override {
        int count = 0;
        for(int v = 0; v < voiceLimit_; v++){
            if(voices_[static_cast<size_t>(v)].isActive()
               && !voiceSilenced_[static_cast<size_t>(v)]){
                count++;
            }
        }
        return count;
    }

    void revertPreset() override;   // staged like a program change
    void comparePreset() override;  // likewise

    // The user group is padded to this many slots, so a panel with 16
    // user tone buttons always has a slot behind each (CZ-101 layout).
    static constexpr int kUserSlots = 16;

    // pd voices are expensive (per-sample transcendentals in pd's Voice and
    // PD generators), so capping polyphony is the main lever for fitting
    // the render inside the audio deadline on a Raspberry Pi
    void setMaxVoices(int maxVoices) override {
        voiceLimit_ = (maxVoices <= 0)
                    ? kMaxVoices
                    : std::min(maxVoices, static_cast<int>(kMaxVoices));
    }

private:
    using PdVoice = Steinberg::Vst::Voice;
    using LineSelect = Steinberg::Vst::LineSelect;
    static constexpr int kNumPdParams = Steinberg::Vst::kNumParams;
    static constexpr int kMaxVoices = Steinberg::Vst::kMaxVoices;

    struct HeldNote {
        int channel;
        int note;
    };

    // parameter registration (constructor only)
    void registerParameters();
    static std::string lineParamId(int line, int offset);
    static std::string paramIdString(int paramId);
    static std::string paramName(int paramId);
    static double defaultParamValue(int paramId);
    // discrete option count of a parameter (0 = continuous)
    static int optionCount(int paramId);

    // factory preset bank (constructor only)
    void registerFactoryPresets();

    // CC -> parameter id, mirroring pd's controller.cpp; -1 when unmapped
    int paramIdForCc(uint8_t cc) const;
    // reverse lookup for describeValue(); -1 when the handle is not ours
    int paramIdForHandle(const Parameter* parameter) const;

    // mirror of PDProcessor::applyParameter: dispatch one normalized value
    void applyParameter(int paramId, double value);
    // push every Parameter whose value changed since the last block into
    // the voices (the standalone equivalent of the host's parameter queue)
    void syncParameters();
    // set a parameter from MIDI and apply it immediately (mid-block)
    void setAndApply(int paramId, double value);

    void handleEvent(const MidiEvent& event);
    void renderSegment(int startFrame, int numFrames);

    // --- preset switching --------------------------------------------------
    // A preset replaces every parameter at once, waveform and envelopes
    // included, and those belong to the voices that are still sounding: a
    // release tail suddenly becomes the new sound, which reads as a note
    // re-attacking by itself. So a switch does not happen where it is
    // asked for. It is staged — fade the output down over a few
    // milliseconds, drop the voices, then load — which costs an
    // imperceptible delay and leaves nothing for the new parameters to
    // land on.
    //
    // Dropping is rtsynth's own: pd's Voice can only be released, never
    // stopped, so a silenced voice is one this host no longer mixes and
    // treats as free. Its EG stops advancing (that happens inside
    // generate()), so it costs nothing until it is allocated again.
    enum class PendingSwitch : uint8_t { None, Program, Revert, Compare };

    void beginPresetSwitch(PendingSwitch kind, int program);
    void applyPendingSwitch();
    void silenceAllVoices();
    // clears the silenced flag: whatever is about to sound on this voice
    void unsilence(size_t index){ voiceSilenced_[index] = false; }
    // one internal-rate tick: every active voice mixed, before volume
    double generateTick();
    // one output-rate sample, interpolated between internal-rate ticks
    double resample();

    void onNoteOn(int channel, int note);
    void onNoteOff(int channel, int note);
    void releaseAllVoices();
    int effectiveMaxVoices() const;
    PdVoice* allocateVoice();
    void updateDetune();

    std::array<PdVoice, kMaxVoices> voices_;
    std::array<Parameter*, kNumPdParams> paramHandles_{};
    std::array<double, kNumPdParams> appliedValues_{};
    PresetBank presets_{parameters_};
    std::vector<HeldNote> heldNotes_;   // mono (SOLO) mode, capacity reserved
    std::vector<float> monoScratch_;

    // Resampler, mirroring PDProcessor's. pd's engine ticks at a fixed
    // kInternalSampleRate (the real CZ's internal clock) whatever the
    // output rate is, so the host side has to interpolate between ticks —
    // without this the pitch would be off by the ratio of the two rates.
    // resamplePhase_ starts at 1.0 so the first output sample ticks.
    PendingSwitch pendingSwitch_ = PendingSwitch::None;
    int pendingProgram_ = 0;
    float switchFadeGain_ = 1.0f;
    float switchFadeStep_ = 1.0f;  // per output sample, set in prepare()
    std::array<bool, kMaxVoices> voiceSilenced_{};

    double internalTickStep_ = 1.0;
    double resamplePhase_ = 1.0;
    double prevTickSample_ = 0.0;
    double currTickSample_ = 0.0;
    SmoothedValue volumeSmoother_;

    double pitchBend_ = 0.0;            // [-1, 1], scaled inside Voice
    double volume_ = 0.5;
    LineSelect lineSelect_ = LineSelect::kLine1;
    bool mono_ = false;
    int detuneOctave_ = 0;
    int detuneNote_ = 0;
    int detuneFine_ = 0;
    uint64_t nextVoiceAge_ = 0;
    int voiceLimit_ = kMaxVoices;   // runtime polyphony cap (--voices)
};

}  // namespace rtsynth
