LouisYOSHINAGA/rtsynth/src/host/StandaloneHost.hpp

#pragma once

#include <atomic>
#include <cstdint>
#include <string>
#include <vector>

#include "../core/Processor.hpp"
#include "../dsp/SmoothedValue.hpp"
#include "../core/SpscRingBuffer.hpp"
#include "MidiInput.hpp"
#include "RawMidiInput.hpp"
#include "RtAudioOutput.hpp"
#include "RtMidiInput.hpp"

namespace rtsynth {

// Glue between the platform layer (RtAudio + a MidiInput backend) and a
// Processor — the standalone equivalent of a DAW hosting a plugin. Three
// threads exist at runtime, and this class is where they meet:
//
//   MIDI thread(s) (RtMidi callback or rawmidi reader)
//       decodes raw bytes -> MidiEvent -> lock-free SpscRingBuffer
//                                              |
//   audio RT thread (RtAudio callback)         v
//       drains the ring into a MidiBuffer, calls Processor::process(),
//       which writes into the driver's planar float buffers
//
//   main thread
//       starts/stops everything, adjusts Parameters (atomic), and polls
//       the xrun / drop counters for reporting — RT threads never log
//
// Swapping RtAudio/RtMidi for another backend (JACK, PipeWire, a plugin
// wrapper, ...) means reimplementing this layer only; core/dsp/synth stay
// untouched.
// Panel actions that have no MIDI message to be expressed as. They are
// queued rather than performed where the button is read, because they
// rewrite the whole parameter set and must not race with a Program Change
// arriving on the audio thread at the same moment.
enum class HostCommand : uint8_t {
    RevertPreset,   // current slot back to the values the instrument started with
    ToggleCompare,  // A/B between the edited sound and the original
};

class StandaloneHost {
public:
    struct Options {
        unsigned int audioDeviceId = RtAudioOutput::kUseDefaultDevice;
        std::string audioApiName;         // "" = auto (prefer direct ALSA)
        int midiPortIndex = -1;           // sequencer backend: -1 = all ports
        // non-empty selects the raw kernel-rawmidi backend instead of the
        // ALSA sequencer (see MidiInput.hpp for the trade-off)
        std::vector<std::string> rawMidiDevices;
        unsigned int sampleRate = 44100;
        unsigned int bufferFrames = 256;
        unsigned int channels = 2;
        // Output attenuation applied *after* the instrument, so it is not
        // part of the sound: an instrument's own gain/volume parameter
        // belongs to the preset and is reloaded with it, which makes it
        // the wrong place to set how loud the box is.
        float masterGain = 1.0f;
        // debug: let the audio backend report devices it could not probe
        bool verboseWarnings = false;
        // debug: mirror received MIDI into the monitor queues, which the
        // main thread drains to trace events and to attribute parameter
        // changes to the CC that caused them (see MidiInput)
        bool monitorMidi = false;
    };

    explicit StandaloneHost(Processor& processor) : processor_(processor){}
    ~StandaloneHost(){ stop(); }

    bool start(const Options& options);
    void stop();

    RtAudioOutput& audio(){ return audio_; }
    MidiInput& midi(){ return *activeMidi_; }

    // Main-thread poll for devices plugged in (or unplugged) since the
    // last call. Returns true when the connected set changed, so the
    // caller can report the new midi().description().
    bool rescanMidi(){ return activeMidi_->rescan(); }

    // Inject an event the panel generated rather than received over MIDI
    // (a button pressing Program Change, say). It joins the block's
    // MidiBuffer alongside the real MIDI, so the instrument handles it
    // through the one path it already has and the audio thread stays the
    // only thread touching voices or presets.
    //
    // Producer: the control thread (GpioButtonInput's event thread is the
    // single producer this queue allows). Returns false if the queue is
    // full, which needs a flood of presses to achieve.
    bool sendControlEvent(const MidiEvent& event){ return controlEvents_.push(event); }

    // Same contract as sendControlEvent: control thread in, audio thread
    // out, applied at the start of the next block.
    bool sendCommand(HostCommand command){ return commands_.push(command); }

    // Runtime master volume, safe from any thread. Ramped in the audio
    // callback rather than applied as a step, so moving it does not click.
    void setMasterGain(float gain){
        masterGainTarget_.store(gain, std::memory_order_relaxed);
    }
    float masterGain() const { return masterGainTarget_.load(std::memory_order_relaxed); }

    // times a block's MidiBuffer filled up and the remaining events were
    // deferred to the next block (nothing is lost; high values mean the
    // audio callback is stalling or a controller is flooding CCs)
    uint64_t midiDeferralCount() const { return midiOverflow_.load(std::memory_order_relaxed); }

private:
    Processor& processor_;
    RtAudioOutput audio_;
    RtMidiInput seqMidi_;
    RawMidiInput rawMidi_;
    MidiInput* activeMidi_ = &seqMidi_;
    MidiBuffer midiBuffer_;
    SpscRingBuffer<MidiEvent, 64> controlEvents_;
    SpscRingBuffer<HostCommand, 16> commands_;
    std::atomic<float> masterGainTarget_{1.0f};
    SmoothedValue masterGainRamp_;  // audio thread only
    std::atomic<uint64_t> midiOverflow_{0};
};

}  // namespace rtsynth
