LouisYOSHINAGA/rtsynth/src/host/MidiInput.hpp

#pragma once

#include <cstdint>
#include <functional>
#include <string>

#include "../core/MidiBuffer.hpp"

namespace rtsynth {

// One wire byte plus whether it opened a read from the device (raw
// backend) or a message (sequencer backend), used by the --midi-dump
// diagnostic to group bytes on output.
struct RawMidiByte {
    uint8_t value = 0;
    bool startsGroup = false;
};

// Runtime surface shared by the MIDI input backends:
//
//   RtMidiInput   ALSA sequencer via RtMidi — flexible (virtual ports,
//                 software sources), but the events travel USB driver ->
//                 kernel rawmidi -> seq bridge -> seq FIFO -> RtMidi
//                 thread before reaching us
//   RawMidiInput  kernel rawmidi device read directly — the shortest
//                 possible path for physical devices; use when the
//                 sequencer route misbehaves (e.g. events lost in bursts)
//
// Backend-specific setup (which ports/devices to open) stays on the
// concrete classes; StandaloneHost and main.cpp use only this interface
// once a backend is opened.
class MidiInput {
public:
    using MonitorFn = std::function<void(const std::string& portName, const MidiEvent& event)>;

    virtual ~MidiInput() = default;

    virtual void close() = 0;

    // consumer side (audio thread), lock-free
    virtual bool pop(MidiEvent& out) = 0;

    // --- hot-plug ------------------------------------------------------
    // A hardware synth is powered on with whatever happens to be attached,
    // so a missing keyboard at startup is a normal state, not an error:
    // the backends open what they find, keep running when that is nothing,
    // and pick up devices as they appear.
    //
    // rescan() is the main thread's periodic poll for that. It opens
    // devices that showed up, releases ones that vanished, and returns
    // true when the connected set changed so the caller can log it.
    // Backends must keep pop() safe against it: the audio thread walks the
    // device slots concurrently, so slots are published atomically and
    // never destroyed while the stream runs.
    virtual bool rescan(){ return false; }

    // Whether at least one device is connected right now.
    virtual bool connected() const = 0;

    virtual uint64_t receivedCount() const = 0;
    // producer-side losses (a queue was full); should stay 0 in practice
    virtual uint64_t droppedCount() const = 0;
    // complete messages that could not be decoded into a MidiEvent —
    // nonzero values are diagnostic gold when notes go missing
    virtual uint64_t undecodedCount() const = 0;

    // Backend-level input errors (e.g. a kernel rawmidi buffer overrun,
    // which silently eats bytes). Any nonzero value explains lost notes.
    virtual uint64_t readErrorCount() const { return 0; }

    // --- debug monitor (--verbose): mirrored events printed by main -----
    virtual void setMonitorEnabled(bool enabled) = 0;
    virtual void drainMonitor(const MonitorFn& fn) = 0;  // main thread

    // --- byte-level dump (--midi-dump) ---------------------------------
    // Mirrors the undecoded wire bytes so the exact stream can be compared
    // against what the instrument does. This is how "did the keyboard send
    // that note-off at all?" gets answered instead of guessed.
    //
    // `startsGroup` marks the first byte of each read() from the device
    // (raw backend), which distinguishes "the device sent a burst with one
    // message missing" from "a whole transfer never arrived" — different
    // faults with different culprits. The sequencer backend only ever sees
    // whole decoded messages, so there it marks each message instead.
    using RawByteFn = std::function<void(uint8_t byte, bool startsGroup)>;
    virtual void setRawDumpEnabled(bool /*enabled*/){}
    virtual void drainRawDump(const RawByteFn& /*fn*/){}  // main thread

    // one line for the startup log, e.g. backend + port names
    virtual std::string description() const = 0;
};

}  // namespace rtsynth
