LouisYOSHINAGA/rtsynth/(commit log)

2026-06-16 RtMdidi, RtAudioを使用した最低限のポリシンセを実装
    - note on, note offのみ対応
    - 生成される音色は単純なsin波
    - 発音時・消音時のノイズは未対応
    - 音声出力の選択のためにconsoleでキーボードからの入力が必要
2026-07-11 Refactor into a VST-like layered architecture
    Restructure the minimal sine synth (gen.cpp / rcv.cpp) into four layers
    shaped after the VST3/JUCE plugin model so instruments, DSP components,
    and audio backends can be swapped or ported independently:
    - src/core/: platform-independent plugin foundation — Processor
    interface (prepare/process/reset with an RT-safety contract), planar
    float32 AudioBufferView, sample-accurate MidiBuffer with raw-MIDI
    decoding, atomic normalized Parameters, and a dependency-free SPSC
    ring buffer (drops the boost requirement)
    - src/dsp/: reusable per-sample components — sine oscillator and a
    click-free linear ADSR (attack from current level, release fr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
    [RtAudioOutput.cpp, RtAudioOutput.hpp, RtMidiInput.cpp]
2026-07-13 Fix latency regression: prefer direct ALSA over sound-server backends
    The refactor changed the RtAudio constructor from the original hardcoded
    LINUX_ALSA to UNSPECIFIED for portability. RtAudio's auto-selection
    probes JACK -> PulseAudio -> ALSA and picks the first API with devices,
    so on a desktop Raspberry Pi OS it lands on PulseAudio/PipeWire. RtAudio
    5.x's Pulse backend leaves the playback buffer length to the server
    (pa_buffer_attr.tlength = -1), so the requested 256-frame buffer is not
    honored and tens of milliseconds of server-side latency are added —
    the regression heard after the refactor.
    - Auto-selection now prefers direct ALSA when it has devices (matching
    the original behavi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
    [RtAudioOutput.cpp, RtAudioOutput.hpp, StandaloneHost.cpp, StandaloneHost.hpp, main.cpp]
2026-07-19 Add hardware control layer: ADC knobs -> parameters, gain smoothing
    First step toward physical controls (knobs/sliders) on a Raspberry Pi:
    - host/ControlInput.hpp: small abstraction over a bank of physical
    analog controls reporting normalized [0,1] values
    - host/ControlLoop.hpp: polling thread (default 100 Hz) that filters
    ADC noise with an EMA, suppresses idle jitter with a ~2-LSB write
    threshold, and writes into the atomic ParameterSet — the hardware
    equivalent of the MIDI CC path, no locks against the audio thread
    - host/Mcp3008Input.{hpp,cpp}: MCP3008 (8ch/10bit SPI ADC) backend via
    spidev, wiring documented in the header
    - main.cpp: --adc <ch>=<param> (repeatable) and --adc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
    [ControlInput.hpp, ControlLoop.hpp, Mcp3008Input.cpp, Mcp3008Input.hpp, SineSynthProcessor.cpp, SineSynthProcessor.hpp, main.cpp]
2026-07-20 Connect to all MIDI input ports by default
    Previously only the first non-"Midi Through" port was opened, so notes
    from a keyboard and CC from a separate controller could not be received
    at the same time. RtMidiInput now opens every input port by default
    (-m <index> still restricts to a single device).
    RtMidi runs one callback thread per opened port, and the SPSC ring
    buffer permits a single producer — so each port owns a dedicated queue
    (its callback thread is the sole producer, the audio thread the sole
    consumer) and pop() drains them all, keeping the MIDI path lock-free.
    A port that fails to open is reported and skipped instead of aborting
    the rest; startup logs the number and names of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
    [RtMidiInput.cpp, RtMidiInput.hpp, StandaloneHost.cpp, StandaloneHost.hpp, main.cpp]
2026-07-20 Hide harmless ALSA probe warnings; add -v/--verbose MIDI monitor
    RtAudio prints "snd_pcm_open error ... Unknown error 524" (ENOTSUPP)
    to stderr while enumerating devices it cannot open — typically an HDMI
    output with no audio sink. The device is simply skipped, so the warning
    is noise: suppress backend warnings by default via showWarnings(false)
    (present in both RtAudio 5.x and 6.x) and re-enable them with -v.
    New -v/--verbose flag also prints every received MIDI event (note on/
    off, CC, pitch bend) with its source port name — useful for checking
    controller wiring. RT safety is preserved: each port's callback mirrors
    events into a per-port monitor queue (same SPSC single-producer rule a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
    [RtAudioOutput.cpp, RtAudioOutput.hpp, RtMidiInput.cpp, RtMidiInput.hpp, StandaloneHost.cpp, StandaloneHost.hpp, main.cpp]
2026-07-20 Fix: MIDI CC did not reach pd's own EG/line parameters
    Root cause: in the pd VST3 plugin, raw MIDI CC is translated into
    parameter changes by the *host*, driven by the mapping table in
    controller.cpp's getMidiControllerAssignment() (CC7 volume, CC3 line
    select, CC14-30/46-62/102-118 the DCO/DCW/DCA EG blocks of whichever
    line CC3 last selected). processor.cpp itself contains no CC handling
    at all — it only ever receives already-translated parameter changes.
    When PdSynthProcessor was written, controller.cpp was treated as VST3
    UI/host plumbing and skipped, but this specific piece of it is host-side
    hosting logic that has no other home in a standalone build. The result:
    only CC7 worked (han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
    [PdSynthProcessor.cpp, selftest.cpp]
2026-07-20 Add GPIO rotary encoder input and parameter-change watching for UIs
    Physical sensors can now drive parameters alongside MIDI CC and ADC
    pots — all three coexist and write to the same ParameterSet, so the
    last-moved control wins like on any synth panel:
    - ControlInput.hpp: new RelativeControlInput interface for controls
    that report movement (encoders) rather than position (pots)
    - ControlLoop: handles both kinds — absolute slots keep the EMA +
    write-threshold path, relative slots nudge the normalized value by a
    configurable step per detent (clamped by Parameter itself)
    - GpioEncoderInput: EC11-style encoders on Raspberry Pi GPIOs via the
    kernel GPIO character device (uapi v2, no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
2026-07-25 Fix MIDI note-off loss: never discard queued events, callback-first open
    Reported symptom: keys sounded on press but releases were frequently
    lost, leaving notes droning forever. Three loss paths fixed:
    - StandaloneHost drained the lock-free queues with pop-then-add and
    DISCARDED the event when the per-block MidiBuffer (256 events) was
    full. After any audio-callback stall (xrun recovery, CPU spike) the
    accumulated burst exceeded one block's capacity and the tail of the
    backlog — typically the note-offs riding behind a CC flood — was
    destroyed. The drain now stops when the block buffer is full and
    leaves the remainder in the queues for the next block a few ms later:
    events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
    [RtMidiInput.cpp, RtMidiInput.hpp, StandaloneHost.cpp, StandaloneHost.hpp, main.cpp]
2026-07-25 Add raw kernel-MIDI backend to bypass sequencer-path event loss
    Field report: with dense overlapping chords, individual note-ons AND
    note-offs never reach our RtMidi callback (verified against the -v
    monitor: offs logged for notes whose ons were missing and vice versa,
    and a hanging note whose off never appeared). Since both the main and
    monitor queues are fed from the same callback and their drop counters
    stayed silent, the loss happens upstream of rtsynth, somewhere along
    USB driver -> kernel rawmidi -> seq bridge -> seq FIFO -> RtMidi
    thread. RtMidi 5.0's handler also skips undecodable events silently
    (RtMidi.cpp alsaMidiHandler), so nothing surfaces when it happens.
    Countermeasures:
    -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
    [MidiInput.hpp, PdSynthProcessor.cpp, RawMidiInput.cpp, RawMidiInput.hpp, RtMidiInput.cpp, RtMidiInput.hpp, StandaloneHost.cpp]
2026-07-25 Fix raw-MIDI thread dangling capture; diagnose crackling root causes
    - RawMidiInput::open captured the range-for loop variable by reference
    in the reader-thread lambda — undefined behavior once the loop
    advances/exits. Capture the heap Device* by value instead.
    - Request an explicit realtime priority (StreamOptions.priority = 70)
    with RTAUDIO_SCHEDULE_REALTIME, and sample the scheduling policy the
    audio thread ACTUALLY got inside the first callback. Missing rtprio
    permission makes RtAudio degrade to normal scheduling silently — the
    most common cause of crackling on a Raspberry Pi — so main now
    reports it once at startup with the exact limits.d fix when denied.
    - Processor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
    [PdSynthProcessor.hpp, RawMidiInput.cpp, RtAudioOutput.cpp, RtAudioOutput.hpp, SineSynthProcessor.hpp, VoiceAllocator.hpp, main.cpp]
2026-07-25 Add DSP load meter, polyphony cap and raw MIDI byte dump
    Analysis of the reported --midi-raw session (52 note-ons / 51 note-offs
    logged): exactly ONE note-off was missing across the whole take — note
    67, the note that hung. The kernel-rawmidi backend therefore cut MIDI
    loss from many events per phrase (sequencer path) to 1 in ~50, and
    [voices] showed the pool repeatedly saturating at 16 while chords
    overlapped, which points at CPU exhaustion for the crackling rather
    than at scheduling (realtime scheduling was confirmed active).
    Diagnostics and levers added:
    - RtAudioOutput measures the render callback's duration against the
    block deadline and exposes current/peak load. -v prints one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
    [MidiInput.hpp, PdSynthProcessor.cpp, PdSynthProcessor.hpp, RawMidiInput.cpp, RawMidiInput.hpp, RtAudioOutput.cpp, RtAudioOutput.hpp]
2026-07-25 Recover notes whose note-off the controller never sends
    The --midi-dump byte trace settles the hanging-note question: the
    note-offs are absent from the wire itself. Six three-note chords produced
    [on 67,71,74] answered by only [67,71] / [67,74] / [67,74] in three of
    them, and every [bytes] line has a matching [midi] line, so rtsynth's
    parser and queues reproduce the stream faithfully. No read errors were
    reported either, so the kernel buffer did not overrun — the controller
    (or the USB link) simply drops one note-off when several keys are
    released together. Crackling is separately confirmed resolved: the load
    meter stayed at ~50% peak.
    A hardware instrument must not drone forever because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
    [StandaloneHost.cpp, StandaloneHost.hpp, main.cpp, selftest.cpp]
2026-07-26 Remove note-off recovery; fix parser bug and sharpen MIDI diagnostics
    New evidence reframes the hanging-note fault: a KORG microKEY on the
    same Pi never reproduces it, and the same KeyLab on a PC never
    reproduces it either. So this is not simply "the keyboard is broken" —
    it is specific to that device combined with Linux's USB-MIDI handling,
    which no amount of host-side masking should paper over.
    - Drop StuckNoteGuard and --note-timeout entirely. Auto-releasing notes
    hides a fault that belongs to the input path, and the user is right
    that it should not exist.
    - MidiStreamParser bug: a status byte did not clear pendingSkip_, so a
    system-common message whose data bytes were cut short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
    [MidiInput.hpp, PdSynthProcessor.hpp, RawMidiInput.cpp, RawMidiInput.hpp, StandaloneHost.cpp, StandaloneHost.hpp, main.cpp]
2026-07-27 Fix stuck voice when two voices hold the same note (sine synth)
    Reported analysis is correct: VoiceAllocator::noteOff() resolved the
    target through findVoiceForNote(), which returns only the NEWEST voice
    matching the note, so a second voice on the same note was left held
    forever — silent to the player until the same key was pressed and
    released again, which retriggered and then released it.
    The duplicate does not come from plain double-allocation (noteOn()
    retriggers an already-held note before allocating). It comes from the
    steal path: with the pool full, noteOn() hands the note to a steal
    target that fades out first; if another voice frees up during that
    ~3 ms fade, a second press of th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
    [VoiceAllocator.hpp, selftest.cpp]
2026-07-28 Make --midi-dump work on the sequencer backend too
    The latest report is a sine-synth run on the default sequencer backend
    (-d 1 --verbose only), and note 71's note-off never appears in the
    event monitor at all: 25 note-ons against 24 note-offs, the single gap
    being the note that droned. Together with the earlier pd run — where
    the byte dump showed the note-off missing from the wire — the loss now
    reproduces across BOTH synths and BOTH input backends, which places it
    upstream of rtsynth entirely.
    Byte-level evidence previously required switching to --midi-raw. RtMidi
    hands us the decoded message bytes, so mirror those into the same dump
    queue and let --midi-dump work unchanged on the def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
    [MidiInput.hpp, RawMidiInput.hpp, RtMidiInput.cpp, RtMidiInput.hpp, main.cpp]
2026-07-28 Report discovered vs connected MIDI ports at startup
    A microKEY run produced no sound at all, and the startup line explains
    why: the only connected port was "microKEY-37 _ CTRL" — the device's
    control port, not the keyboard. Many keyboards expose their notes on a
    second sequencer port, so connecting to one port and hearing nothing
    looked like a total MIDI failure when it was a routing question.
    The startup message now lists every port the sequencer offered and
    marks each as connected or skipped, e.g.
    MIDI input: ALSA sequencer (RtMidi), connected 1 of 2 port(s):
    [connected] microKEY-37 ... _ CTRL 24:0
    [skipped] microKEY-37 ... _ KBD 24:1
    which separates "the note port was n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
    [RtMidiInput.cpp, RtMidiInput.hpp]
2026-07-28 Stress-test the MIDI handoff queue under real thread contention
    With both keyboards connected to the same running process, the KeyLab
    still drops note-offs while the microKEY never does. Same binary, same
    backend, same drain loop, same synth, same audio thread — the only
    variable is the device, which rules out this codebase as the cause.
    The one component that could in principle have lost events without
    leaving a trace is the lock-free MIDI queue, so verify it instead of
    asserting it: a real producer thread pushes 200k sequence-numbered
    events through a deliberately undersized (64-slot) buffer, forcing
    constant wrap-around and full conditions, while the consumer checks
    every event arrives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
2026-07-29 Reorganize README into usage and development halves
    The README had accumulated a lot of triage material while we chased the
    MIDI dropouts, so setup instructions, CLI reference and debugging steps
    were interleaved. Split it into a "usage" part (build, Pi setup, running,
    hardware controls, pd synth) and a "development/debug" part (layering,
    thread model, extension guide, known issues, diagnostics).
    Record the resolved cause of the hanging notes: on Pi 3B and earlier the
    dwc_otg host controller silently drops split transactions for a
    full-speed USB MIDI device behind the high-speed hub, and
    dwc_otg.speed=1 in cmdline.txt fixes it. This is now a required setup
    step rather than an open investiga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
2026-08-13 pdのsubmodule参照先をmain最新に追従するように設定
2026-08-14 Fix pd submodule breakage; add preset bank and a display module
    The external/pd bump appended kParamMonoTrigger/kParamPolyTrigger to
    ParamId, growing kNumParams. PdSynthProcessor registered its parameters
    from a hand-written list, so the two new handles stayed null and the
    constructor dereferenced them: `--synth pd` segfaulted at startup.
    registerParameters() now walks 0..kNumParams-1 and gives even an unknown
    id a slot, so a future bump cannot leave a hole. The CC map added in the
    same bump (line select, detune, waveform, Mono/Poly Mode On) is mirrored
    too, and now lives in one place that both MIDI dispatch and the display
    read.
    Presets: PresetBank holds several snapshots of a ParameterSet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
    [ParameterDisplay.hpp, ParameterMonitor.hpp, ParameterWatcher.hpp, PdSynthProcessor.cpp, PdSynthProcessor.hpp]
2026-08-14 Build the pd parameter id/name strings by appending
    GCC 12 reports a bogus -Wrestrict overlap warning (with an absurd
    9223372036854775810-byte memcpy) for `"L" + std::to_string(n)`: that
    overload prepends to a temporary string, and the optimizer loses track of
    how long the temporary is. Routing the three prefix+number sites through
    one helper that appends instead produces the same strings and gives the
    warning nothing to latch onto.
    Claude-Session: https://claude.ai/code/session_01K5fiFFdEEQSok2Xf3RqG6b
2026-08-14 Fall back to a real device when ALSA's "default" cannot be opened
    Fitting an I2S DAC means disabling the onboard card, which leaves the
    ALSA "default" PCM pointing at nothing. RtAudio 5.x's ALSA backend
    hardwires device 0 to that PCM (RtApiAlsa::probeDeviceOpen) and
    getDefaultOutputDevice() returns 0, so starting without -d failed on a
    box where speaker-test on the DAC works fine. "default" is also absent
    from --list, because devices that fail to probe are filtered out, so the
    error named a device the user had no way to see.
    Without an explicit -d, open() now treats the backend's default as the
    first candidate only and falls back to the devices that actually
    enumerated, reporting which one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
    [RtAudioOutput.cpp, RtAudioOutput.hpp, StandaloneHost.cpp]
2026-08-14 Sweep every openable device id when the default one fails
    RtApiAlsa numbers devices twice and the two disagree. getDeviceCount()
    and getDeviceInfo() count the ALSA "default" PCM as id 0 only when
    snd_ctl_open("default") succeeds, while probeDeviceOpen() always reserves
    id 0 for it and starts hardware devices at 1. Disabling the onboard card
    for an I2S DAC makes "default" unopenable, so every hardware device gets
    listed one lower than the id needed to open it: --list showed the DAC as
    [1], and -d 1 opened hw:0,0 (the HDMI card) instead.
    The fallback added for this only tried ids from the enumeration, so it
    could never reach the shifted one. It now sweeps the whole range
    openStream() accepts,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
    [RtAudioOutput.cpp, RtAudioOutput.hpp]
2026-08-14 Detect an unusable ALSA "default" and say that no -d value can help
    Sweeping device ids was the wrong conclusion: -d 2 on the reporting
    machine returns "output device parameter value is invalid", which pins
    getDeviceCount() at 2. RtApiAlsa's opening numbers are "default" at 0 and
    hardware from 1, so the second card needs id 2 — one past the end of the
    range openStream() accepts. In this state the DAC is unreachable through
    RtAudio's ALSA backend by any id, and no amount of guessing fixes it.
    What does fix it is making snd_ctl_open("default") succeed, because that
    is the term the counting side includes and the opening side assumes: with
    it, both numberings line up and plain "default" alrea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
    [RtAudioOutput.cpp, RtAudioOutput.hpp]
2026-08-14 Name the ALSA card id correctly in the asound.conf advice
    The suggested config used snd_rpi_hifiberry_dac, which is the card's
    name, not its id; ALSA rejects it with "Cannot get card index for ...".
    `aplay -l` prints the id before the brackets and the name inside them,
    which is the opposite of what the advice said. Use the id
    (sndrpihifiberry), spell out which field it is, and list the machine's
    own cards with their ids so the value can be copied rather than guessed.
    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
    [RtAudioOutput.cpp]
2026-08-14 Let -v select which kinds of trace output to print
    -v printed MIDI events, parameter changes, the DSP load meter and the
    voice count all at once, which is the wrong shape for the thing it is
    used for: chasing one of those four means reading it out of the other
    three. It now takes an optional comma-separated list — -v midi,param,
    --verbose=load — and keeps printing everything when given no argument.
    "warnings" (audio backend messages) becomes a category of its own rather
    than riding along with the rest, so StandaloneHost::Options no longer
    overloads a single verbose flag: it takes verboseWarnings and monitorMidi
    separately, and main derives them from the categories. The MIDI monitor
    queu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
    [StandaloneHost.cpp, StandaloneHost.hpp, main.cpp]
2026-08-14 Document the I2S DAC setup as a three-step procedure
    Fitting the DAC took a long detour because two different failures look
    like "no sound" and the fix for one causes the other. PipeWire opens
    every card at login and does not release it when idle, so the DAC comes
    back Device-or-resource-busy; stopping PipeWire to clear that also
    removes ALSA's "default", which trips the RtAudio 5.x numbering mismatch
    and puts the card out of reach of every -d value. The README described
    only the second half, so following it from the busy state made things
    worse.
    Rewrite the audio-output section as three ordered steps — bring the card
    up, give it to rtsynth exclusively (a WirePlumber rule if the desktop
    s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
2026-08-25 Show the live parameter on a 16x2 I2C LCD
    The display module landed the decision half of this — ParameterMonitor
    works out what should be shown and hands DisplayLines to any number of
    ParameterDisplay backends — with the console as the only backend. This
    adds the hardware one, so a headless synth on a Pi says what it is doing
    without a terminal attached.
    - host/I2cLcd1602: HD44780 16x2 LCD behind the usual PCF8574 I2C
    backpack, driven through the kernel's I2C character device, so no
    external library is pulled in. The 4-bit init-by-instruction sequence
    and the backpack's bit assignment are in the header.
    - host/TextDisplay: the four-method seam over a character display, so the
    ha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
2026-08-25 Keep every displayed name and value inside the LCD's 16 columns
    On the hardware synth the third resonance waveform arrives as
    "Resonance III Tra" — LcdParameterDisplay truncates to the display width
    and says nothing, so nothing fails, the word is just cut. A sweep of
    every parameter over its whole range found three offenders: that waveform
    (18 characters), the ends of the detune fine range (17), and the six
    "Lx EG Sustain Point" names (20).
    Shorten them at the source, so the console and the LCD keep showing the
    same text:
    - waveforms: "Resonance I/II/III ..." -> "Reso I Saw", "Reso II Tri",
    "Reso III Trap". The suffix is the part that distinguishes them, so
    abbreviating the shared wo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
    [PdSynthProcessor.cpp, selftest.cpp]
2026-09-07 Connect MIDI devices as they appear instead of requiring one at startup
    A synth started at power-on comes up before USB enumeration finishes, so
    "no MIDI device" is the normal state at that moment, not a failure. Both
    backends returned false from open() in that case and StandaloneHost
    turned that into a failed start, so the process exited before the
    keyboard was ever seen — and a cable pulled later left the device gone
    for the rest of the run.
    Give MidiInput a rescan() the main thread calls once a second. It opens
    what appeared and releases what vanished; open() no longer failing is
    enough to keep the host running, so requireMidi goes away rather than
    becoming an option nobody can want.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
    [MidiInput.hpp, RawMidiInput.cpp, RawMidiInput.hpp, RtMidiInput.cpp, RtMidiInput.hpp, StandaloneHost.cpp, StandaloneHost.hpp, main.cpp]
2026-09-07 Say why a device is missing instead of suggesting ids to guess
    A device that fails to probe is filtered out of --list, so a card held by
    another process or an ALSA "default" pointing at nothing simply does not
    appear, and the backend's warning that says which and why is suppressed
    unless --verbose is given — which --list never passed on. It does now, so
    `--list -v warnings` shows the reason next to the gap it explains.
    When nothing enumerated at all, the failure help offered "try another id
    with -d", which is advice to guess at an empty list. Name the two states
    that actually produce it on a Raspberry Pi — another process holding the
    card, and a "default" left dangling by dtparam=audio=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
    [RtAudioOutput.cpp, main.cpp]
2026-09-07 Name an already-running rtsynth as a possible holder of the card
    ALSA hardware devices are exclusive, so an rtsynth started at boot by
    systemd blocks every later copy from opening the DAC — and the failure it
    produces is the same "no output device found" as a misconfigured
    "default", with nothing pointing at the real cause. On a machine being set
    up to launch the synth at power-on that is the likely holder, not
    PipeWire, so say both and say why a second copy can never share the card.
    Claude-Session: https://claude.ai/code/session_013bd3BNFJhnhh72sUSznc27
    [RtAudioOutput.cpp]
2026-09-12 Add panel buttons, with preset stepping that wraps at both ends
    A hardware synth wants its presets under a finger, not under a Program
    Change from a keyboard that may not have the buttons for it. Tact
    switches are the cheapest way there: GpioButtonInput requests the lines
    with the internal pull-up so a switch to GND is the whole circuit, and
    lets the kernel debounce them (GPIO_V2_LINE_ATTR_ID_DEBOUNCE, falling
    back to raw edges where that is refused).
    A press is turned into a MidiEvent and pushed onto a new control queue
    that the audio callback drains alongside the MIDI queues, so a preset
    switch from a button and one from a Program Change are the same event
    arriving on the same thread —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
2026-09-12 Add a revert button that undoes a preset's edits
    CC, pots and encoders write the live parameters, which is what makes
    "edit any preset" work without a second set of plumbing — but it also
    means an edit is permanent with no way back. Reloading the slot cannot
    serve as the undo, because select() stores the live values into the slot
    on the way out: once you have switched away and back, the slot's own copy
    *is* the edited sound.
    So keep a second copy. PresetBank now holds the values each slot was
    registered with, never overwritten, and revertCurrent() restores the
    current slot from it — the values the instrument starts with, which is
    what "back to how it was at power-on" means to someone ho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
    [ParameterMonitor.hpp, StandaloneHost.cpp, StandaloneHost.hpp, main.cpp, selftest.cpp]
2026-09-12 Put the panel buttons in the autostart examples
    The unit files are what a synth that launches at power-on actually runs,
    so leaving --button out of them meant the buttons were documented
    everywhere except where they get used. Add them, add the group membership
    the GPIO and audio devices need under User=, and say that a hardware
    option that cannot open its device fails the start — which turns a typo
    into a restart loop when paired with Restart=on-failure, so the command
    belongs in a unit only after it has run by hand once.
    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
2026-09-12 Collect every pin into one table for assembly
    The wiring is spread across six steps, which is right while building one
    module at a time and wrong when checking a finished panel. Add a single
    table of every pin in use, and make the indicator-LED sketch concrete for
    the preset buttons it will actually be wired to — including which leg
    faces which rail, and that the LED branch costs no GPIO.
    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
2026-09-12 Restore the wiring that has no Pi pin to the summary table
    The pin table was built by listing what connects to the header, which
    silently dropped the DAC's SCK — a pin that goes to GND on the module
    itself and, left floating, stops the DAC producing sound at all. Put it
    back, and add the other steps that are real work but never appear in a
    pin column: the module's solder jumpers, its audio output, the LCD
    contrast trimmer, and that all the header's GND pins are the same net.
    Also warn that the indicator LED's branch must be fed from 3V3 and not
    5V. With the switch open that branch sits directly on the input pin, so
    a 5V feed puts the pin above its absolute maximum and drives current
    into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
2026-09-12 Make -g a master volume that presets cannot overwrite
    -g wrote the instrument's own gain/volume parameter, which is part of the
    preset: the bank snapshots every parameter, so switching preset loaded
    that slot's stored volume and the setting was gone. It looked like -g
    only worked on the preset selected at startup, because that is exactly
    what it did.
    How loud the box is belongs to the box, not to the patch. Apply it in the
    host after process() instead, ramped through a SmoothedValue so it can be
    moved at runtime without clicking, and skipped entirely at unity so the
    default path costs nothing. Preset switches and reverts now leave it
    alone, and the instrument's own gain stays reachable thro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
    [StandaloneHost.cpp, StandaloneHost.hpp, main.cpp]
2026-09-17 Complete the CZ-101 factory bank with Percussion
    The sixteenth and last preset, converted like the rest. The bank is now
    16 factory sounds followed by the three user slots, so list them in the
    README: the set is fixed, which it was not while the files were arriving
    a handful at a time.
    Every slot was checked from a fresh instrument — all sound, peaking
    between 0.086 and 0.126, and their attacks match what the names promise
    (Organ, Synth Bass and Percussion immediately; Trumpet, Violin, Strings,
    Flute and Whistle around a second).
    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
2026-09-17 Follow pd's move to a fixed internal sample rate
    pd stopped giving its voices a sample rate: the engine now ticks at
    kInternalSampleRate whatever the output rate is, and the host interpolates
    between ticks (PDProcessor::setupProcessing + resample). Calling
    Voice::setSampleRate no longer compiles, and simply putting that method
    back upstream would undo a deliberate change to keep the DSP at the real
    CZ's clock — this host exists to reimplement the plumbing that the VST3
    side does, so mirror the resampler here as it already mirrors the CC map
    and the voice pool.
    Pitch checked against the point of the change: note 69 measures 439-440 Hz
    at 44.1, 48, 96 and 22.05 kHz. Without the resampler 48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
    [PdSynthProcessor.cpp, PdSynthProcessor.hpp]
2026-09-17 Silence sounding voices before a preset switch
    A preset replaces every parameter at once, waveform and envelopes
    included, and those belong to the voices that are still sounding: a
    release tail would suddenly be rendered with the new sound, which is
    heard as a note re-attacking by itself.
    Releasing the voices first, as asked for, does not fix it — pd's Voice
    has no hard stop, only noteOff, so the tails keep ringing and still get
    the new parameters. So stage the switch instead: fade the output down
    over 5 ms, drop the voices, then load. The delay is imperceptible and
    there is nothing left for the new parameters to land on.
    Dropping is this host's own, since pd cannot do it: a silenced voi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
    [PdSynthProcessor.cpp, PdSynthProcessor.hpp, StandaloneHost.cpp, selftest.cpp]
2026-09-17 Take the user slots from preset files too
    The three user slots held the bare parameter defaults because there was
    nothing else to put in them. There is now: the same conversion that
    builds the factory bank reads presets/user/, so Init and the two demo
    slots are real patches saved from the plugin rather than a placeholder.
    The generator takes <Name>=<dir> groups and emits one table per group, in
    the order given, which is what keeps the user slots at the end of the
    bank — adding a factory sound still cannot renumber them. Renamed to
    PdPresets.hpp, since it is no longer only the factory ones.
    The tests that checked the user slots equalled the defaults were checking
    the placeholder, so repla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
    [PdSynthProcessor.cpp, selftest.cpp]
2026-09-28 Accept presets from any version of the plugin
    The converter pinned the state version at 3 and refused anything else, so
    the moment pd added parameters every existing preset stopped converting —
    which is backwards, since pd only ever appends parameters and says so:
    const.h now maps each version to a parameter count, and setState reads an
    older stream short and leaves the rest at their defaults.
    So stop reading the version as a gate. The file's own value count is the
    same information, and the generated table carries it per preset; the
    instrument fills anything past it from defaultParamValue, exactly as pd
    does. Old and new presets mix freely, and the static_assert now catches
    the case that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
    [PdSynthProcessor.cpp, selftest.cpp]
2026-09-28 Write the generated header as UTF-8 regardless of the platform
    Python picks the platform's default codec for a text file it is not told
    about. On a Japanese Windows that is cp932, which cannot encode the em
    dash in the header's own comments, so the tool got all the way through
    the conversion and then died on the write. Name the encoding, and the
    newline with it: a generated file tracked in git should not change shape
    with the machine that produced it.
    Printing has the same hazard for the same reason, and neither the usage
    text nor the listing is worth failing a conversion over, so the streams
    are reconfigured to replace what the console cannot render.
    Checked by running the conversion with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
2026-10-10 Add an MCP23017 expander panel with an EG edit page (2 x 8 encoders)
    Hardware: Mcp23017Panel drives encoders, buttons and LEDs on up to 8
    MCP23017 I/O expanders over one I2C bus (I2cBus, I2C_RDWR), polled or
    woken by a shared INTA line. Pins are checked at setup (GPA7/GPB7 are
    output-only on current silicon, no pin used twice).
    Behaviour: EgEditPanel maps row R / encoder K onto line<R>_<eg>_<field>K
    of the pd synth; dco/dcw/dca and rate/level buttons pick the page, sus
    and end held + encoder K set the sustain / end point, LEDs show the
    selection and optionally the EG steps.
    The panel is described in a config file (--panel, panels/pd_2x8.conf)
    so it can grow without code changes.
    Refactori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
2026-10-11 Rework the EG panel for the planned hardware: one editor per line
    The panel now follows the planned layout — per line: an EG cycle switch
    with 3 LEDs, 8 encoders, a rate/level switch with 2 LEDs, a sustain
    switch with 8 LEDs and an end switch with 7 LEDs; plus a global line
    select switch with 4 LEDs.
    - Selection state (EG, rate/level, sus/end held) is kept per row, and
    roles are row-scoped: row1.eg, row2.sus, row1.sus3 (LED), ...
    - sus / end: a tap steps to the next point, hold + turn encoder K sets
    step K directly. Their LEDs show the parameter's real value at all
    times, so presets and MIDI CC are reflected.
    - "line" cycles pd's line_select (Line 1, Line 2, 1+1', 1+2'), with
    line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
2026-10-11 Panel: sus/end as step buttons, LEDs on a 74HC595 chain
    - sus / end are plain "next point" buttons now (Off, 1..7 / 2..8); the
    hold-and-turn shortcut is gone and the encoders always edit values.
    Sustain has 7 LEDs, all dark for Off.
    - ShiftRegisterLeds drives LEDs on a daisy chain of 74HC595 over SPI,
    with CE1 as the latch so all outputs switch at once. LedOutput gains
    flush(), which EgEditPanel calls once per tick when an LED changed.
    - Panel config: "shift-register <spidev> <chips>" and sr<chip>.<bit>
    LED pins, with range and double-use checks.
    - panels/pd_2line.conf: inputs on 3 MCP23017, the 42 LEDs on 6 x 595.
    Claude-Ses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
2026-10-12 Full front panel: tone select, compare, waveforms, detune/vib, abs
    Implements the planned CZ-101 style panel (33 switches, 19 encoders,
    61 LEDs) on 6 x MCP23017 + 8 x 74HC595, described by
    panels/pd_panel.conf.
    Panel logic is now a small framework instead of one EG class:
    - PanelLogic resolves config roles to button / encoder / LED handlers
    (LEDs may be off, on or blinking) via feature modules, and provides
    abs.up/down (step whatever was touched last), discrete-aware nudging
    and generic param:<id> roles that need no code.
    - PdPanel.hpp: PdLineEditor (per line DCx, rate/level, sus/end on shared
    step LEDs, waveforms in binary, key follow select), PdLineSelect,
    PdToneSelect (preset/u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
2026-10-12 Panel: four LEDs per waveform display
    Waveform numbers (wave1 1..8, wave2 Off..8) now show in four bits, so
    8 = 1000 instead of a blink. The LED count rises to 65, so the 74HC595
    chain grows to 9 chips; the waveform LEDs get their own two chips.
    Claude-Session: https://claude.ai/code/session_01ECx8SeCewTgY4n2mMK9Sgq
2026-10-12 Panel: one LED per waveform, tone bank/page switch at once
    - Waveform LEDs are one per waveform (rowR.waveN.1..8), the selected one
    lit, wave2 Off dark. The panel has 81 LEDs: 10 x 74HC595 plus the
    compare LED on a spare MCP23017 output-only pin.
    - preset / user / page now switch the tone immediately (preset 3 ->
    user 3, 3 -> 11), so the LEDs always show the sounding tone. A second
    press before the switch lands builds on the requested tone.
    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
2026-10-12 Panel: key follow mode on the waveform buttons (wave1 + wave2 chord)
    - Pressing a row's wave1 and wave2 together toggles key follow mode; in
    it the same buttons step the DCW (wave1) and DCA (wave2) key follow
    0..9. Single waveform presses now act on release, so half of a chord
    never steps a waveform. rowR.keyfollow remains as an optional button
    for the same toggle.
    - Waveform LEDs go to 9 per display (rowR.waveN.1..9) and a rowR.kf LED
    shows the mode: waveform 1..8 / Off, or key follow 0 (dark) .. 9.
    - panels/pd_panel.conf drops abs up/down and the keyfollow buttons:
    67 inputs fit 5 x MCP23017; the 87 LEDs are 80 on 10 x 74HC595 and
    7 on MCP23017 output-only pins.
    Co-Authored-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
2026-10-12 Panel bring-up: tolerate missing expanders, wiring trace, LED test
    So the final panel config can be used while the hardware is built one
    chip at a time:
    - Mcp23017Panel skips an expander that does not answer at open (one
    warning, its controls idle) instead of failing the whole panel, and
    warns when a chip's pins change without its INT line firing (INTA not
    wired: the chip would only be read every 20 ms).
    - -v panel prints every panel button and encoder event by role and pin.
    - --panel-led-test lights each panel LED in turn and prints its role and
    pin.
    - README_HW Step 7: a step-by-step bring-up order.
    Claude-Session: https://c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
2026-10-17 Panel config: swap encoder A/B so clockwise increases
    On the real panel (ALPS encoders on RECNV-3 boards, A terminal on the
    first pin of each pair) every encoder ran backwards. Swap the pins of
    all encoder lines in the shipped config so the documented wiring gives
    clockwise = up; the wiring itself does not change.
    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
2026-10-17 Panel: step LEDs show a sustain only when it lies before the end
    On the CZ a sustain point never lies beyond the end point, so the step
    LEDs are read as "two lit = lower is sustain, higher is end; one lit =
    the end". A sustain at or after the end (which pd's parameters allow)
    is now shown as no sustain instead of lighting a second LED that would
    read as the wrong way round.
    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
2026-10-19 LCD: editable display layout file; drop the misleading ms on EG rates
    The EG rate value no longer claims a duration in milliseconds: the figure
    did not match what the synth actually does, so the rate is shown as its
    plain 0..1 value like the levels.
    What the two LCD rows say now comes from text templates that
    --lcd-layout <file> can override: per parameter id (glob patterns, last
    match wins, captures as {1} {2}), for preset switches and for the
    startup/stop messages. lcd/pd_lcd.conf ships the current wording as the
    starting point.
    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
2026-10-29 Docs: link the 74HC595 chips through 1 kOhm against hold-time races
    With the chain grown to eight chips on a breadboard, SRCLK reached the
    later chips late enough that each read the next bit from its neighbour:
    the LED next to the one asked for lit as well, from the first bad link
    onward. A 1 kOhm resistor in the QH' -> SER link delays the data enough
    and fixed it. README_HW.md now wires every link that way and lists the
    symptom; pd_panel.conf points to it.
    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
2026-10-29 Panel: one preset button alternates preset and user banks
    The user button is gone: each press of preset goes to the same number in
    the other bank (preset 3 -> user 3 -> preset 3 ...). The preset and user
    LEDs stay and show which bank the tone is in. 4.A1 becomes a spare input.
    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
2026-11-02 Panel: a switch on an unconfigured pin no longer reads as a missing INTA
    The INTA check compared the whole port, but only the pins the config
    names raise INT. A switch wired ahead of its config line (here noise /
    ring on chip 3) changed the port silently and drew the 'is its INTA
    wired?' warning although INTA was fine. Compare the configured inputs
    only.
    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
2026-11-03 Panel: COMPARE is lit on the edit and dark on the original
    Instead of blinking while the original plays, the LED now simply says
    which sound is live: on while the edited tone plays, off while the
    original is being compared (and off when there is nothing to compare).
    The button already toggled original <-> edit; only the LED changes.
    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
2026-11-03 KiCad-pihat: pihatの回路図を追加（wip）
2026-11-04 KiCad-pihat: pihatの回路図を作成
